StarCoder14/Auto_DRIVING/다음_할일.md

# 인수인계 / 다음 할 일 (2026-10-27 기준)

하드웨어는 다 움직인다. 지금은 **오렌지파이에서 리모컨으로 거리를 정해 자율주행을 시작**하는 단계다.
자세한 기록은 `실물_올리기.md` 6-7 절.

## 지금 상태

| 항목 | 상태 |
|---|---|
| 앞 거리 센서(샤프 A0), 센서 서보(D9), 자이로, 부저(D13) | 확인됨 |
| 조향 서보 D10 | 확인됨 (D8 에 꽂혀 있던 선을 D10 으로 옮김) |
| DC 모터 2개, L9110S D4~D7 | 펌웨어 고친 뒤 명령 없을 때 멈춤 확인 |
| 오렌지파이 ↔ 나노 USB 직결 | 확인됨. 50 Hz 상태 줄, 감시 정지 동작 |
| 리모컨 펌웨어 (거리 입력 + ▶\|\| 출발) | 컴파일·업로드 성공. 켜면 `사람조종`(대기) 확인 |
| 리모컨 ▶\|\| 로 실제 출발, 도착 | **아직 확인 안 함** |
| 전원만 켜면 자동 대기 (`scripts/start_car.sh` + crontab) | **안내만 함. 등록 확인 안 함** |
| 바닥에서 실제 자율주행 | **아직** |

## 어떻게 동작하나

- 아두이노: 센서 훑기, 모터·조향 출력, 감시 정지, **리모컨 읽기**. 켜면 멈춘 상태.
- 오렌지파이 `run_robot.py`: 지도, 하이브리드 A\*, 추종. 리모컨이 '멈춤' 이면 `사람조종` 으로 기다린다.
- 리모컨: 숫자(cm) → ▶\|\| 를 누르면 아두이노가 `G,<cm>` 를 보내고, 파이가 그 순간 차가 보는 방향으로 목적지를 잡아 출발.
  달리는 중 아무 버튼 = 정지. 다시 ▶\|\| = 이어 감. EQ = 숫자 지우기.
- `run_robot.py` 가 안 떠 있으면 리모컨을 눌러도 삑 소리만 나고 안 움직인다. 자동으로 띄우려면 `scripts/start_car.sh`.

## 보드 작업 방법 (노트북 없이)

- 보드 코드: `~/Auto_DRIVING` (github.com 에서 clone 한 뒤 `rccar/link.py`, `rccar/robot.py` 를 손으로 고침 = 이 레포와 같은 내용)
- 아두이노 스케치: `~/rccar_arduino/rccar_arduino.ino` (= 이 레포 `firmware/rccar_arduino/rccar_arduino.ino` 와 같은 동작)
- **`~/Auto_DRIVING` 를 지우거나 다시 clone 하지 말 것.** 이 레포가 올라가기 전에는 손으로 고친 게 날아간다.
- 포트: `ls /dev/ttyUSB*` 로 확인 (0, 1 이 바뀜)
- 컴파일은 `--clean` 필수 (보드 시계가 틀어짐), 업로드는 리셋 버튼 손으로. 명령은 `실물_올리기.md` 6-7.
- 편집기는 `nano` (Ctrl+W 찾기, Ctrl+_ 줄 번호로 가기, Ctrl+O 저장, Ctrl+X 나가기)

## 바로 다음

1. **리모컨 출발 시험** (모터 빼고도 됨): `run_robot.py` 실행 → `1 0 0` → ▶\|\| → 화면 위치가 1.0 까지 늘고 `결과: 도착`
2. 센서 서보와 DC 모터 다시 꽂기. **센서 서보가 빠져 있으면 지도가 엉뚱하게 찍힌다.**
3. 바퀴 띄우고 ▶\|\| → 두 바퀴가 같은 방향으로 도는지. 한쪽이 거꾸로면 그 모터 선 두 가닥을 바꿈
4. 바닥에서 첫 주행: 장애물 없이 100 cm. 출발 전 2 초 가만히 (자이로 영점)
5. `scripts/start_car.sh` 를 `~/start_car.sh` 로 두고 crontab 등록, 재부팅해서 전원만으로 대기되는지 확인

## 알려진 문제와 주의

- **0.33 m/s 아래 명령은 모터가 꺼진다** (`MOTOR_MIN_PWM = 60`). 계획기가 감속하면 서 버릴 수 있다. 안 가면 `--max-speed` 를 올리거나 이 값을 실측으로 낮춘다.
- **도착 판정 반경 0.45 m, 계획기 설정이 큰 차(48 cm) 기준.** 30 cm 보다 짧은 거리는 바로 도착할 수 있다. 차 크기에 맞게 줄이는 작업이 남았다 (step 0.40→~0.15, goal_tol 0.45→~0.15, grid_res). 리모컨 거리 보정(`robot.py` 의 `+ self.C.goal_tol`)도 같이 볼 것.
- **엔코더가 없어** 거리는 명령 속도 × 시간으로 짐작한다. 3 m 달리기로 명령 대비 실제 속도를 재서 보정할 것.
- 펌웨어 후진은 D4, D7 이 PWM 핀이 아니라 제대로 안 된다. 뒤 센서가 없어 후진을 꺼 둬서 지금은 상관없다.
- 리모컨은 수신기를 향해 눌러야 한다. 비상 정지는 **모터 배터리 스위치**가 제일 확실하다.
- 오렌지파이 전원은 아직 콘센트. 5V 3A 이상 USB-C 보조배터리가 있어야 선 없이 달린다.

## 측정 남은 것 (`rccar/car_specs.py`)

윤거, **최소 회전 지름 좌/우** (가장 중요), 조향 서보 중앙값, 앞 센서 위치·높이, 시험 공간, 기둥 지름·높이.
안 잰 값은 기본값(최대 조향 32도 등)으로 채워 달린다.

## 그 뒤

- 시뮬레이터·계획기 설정을 22 cm 차에 맞게 축소 (계획 먼저 보여주고 진행)
- 계획서 수정안(센서 샤프·보드·방법), 보고서 서론/배경. 보고서 마감 약 11/8
