StarCoder14/Auto_DRIVING/실물_올리기.md

# 실물에 올리기

시뮬레이터에서 검증한 알고리즘을 오렌지파이와 아두이노로 옮기는 방법이다.
부품이 오기 전에 만들어 둔 것과, 부품이 온 뒤에 할 일을 나눠 적었다.

작성: 2026-09-16

---

## 1. 무엇이 어디서 도는가

| 담당 | 파일 | 하는 일 |
|---|---|---|
| 오렌지파이 | `run_robot.py`, `rccar/robot.py` | 지도 만들기, 하이브리드 A\*, 경로 추종, 예측 정지 |
| 아두이노 | `firmware/rccar_arduino/rccar_arduino.ino` | ToF 2개와 자이로 읽기, 센서 서보 훑기, 조향과 모터 출력, 감시 정지 |
| 둘 사이 | `rccar/link.py` | 글자로 주고받는 통신 규약 |
| 부품 없이 시험 | `rccar/fake_arduino.py` | 아두이노인 척하는 가짜 장치 |

알고리즘 자체는 시뮬레이터와 같은 코드를 쓴다 (`rccar/hybrid.py`).
바뀌는 것은 센서 값을 어디서 받고 명령을 어디로 보내느냐뿐이다.

## 2. 통신 규약

한 줄짜리 글자로 주고받는다. 시리얼 모니터로 눈으로 볼 수 있어야 고치기 쉽다.

```
아두이노 -> 파이   S,<ms>,<자이로>,<센서각>,<앞거리>,<뒷거리>,<실제명령>,<플래그>*<검사값>
파이 -> 아두이노   C,<속도mm/s>,<조향0.1도>*<검사값>
```

- 검사값은 앞 글자들을 XOR 한 16 진수 두 자리다. 선이 흔들려 깨진 줄은 버린다.
- 아두이노는 50 Hz 로 상태를 보낸다.
- **명령이 0.3 초 안 오면 아두이노가 스스로 차를 세운다.** 파이가 죽어도 차는 선다.
- 자세한 항목 설명은 `rccar/link.py` 머리말에 있다.

## 3. 부품 없이 지금 할 수 있는 것

```bash
python -m tests.test_robot                 # 통신과 주행 시험 7개 (몇 초)
python run_robot.py --fake --seed 2005     # 가짜 아두이노로 전체 주행
```

가짜 아두이노는 서보가 멈춘 뒤 재는 것, 자이로 편향과 잡음, 통신 지연 0.02 초,
감시 정지까지 흉내 낸다. 그래서 통신 형식과 주행 논리는 부품 없이 검증된다.

흉내 내지 못하는 것은 실물에서 처음 만난다. 서보의 기계적 흔들림, 변속기의 후진 지연,
바퀴 미끄러짐, 센서가 유리나 검은 면을 놓치는 것이다.

## 4. 배선

핀 번호는 `.ino` 파일 위쪽 상수에서 바꾼다. **2026-10-26 기준 실제 배선** (처음 계획에서 많이 바뀌었다):

| 부품 | 아두이노 핀 |
|---|---|
| 자이로 MPU6050 (I2C) | SDA A4, SCL A5 |
| 앞 거리 센서 샤프 GP2Y0A21 (아날로그) | A0 |
| 센서 서보 (앞 센서 좌우로 훑기) | D9 |
| 조향 서보 | D10 |
| DC 모터 드라이버 L9110S, 모터 2개 | B-1A D4, B-1B D5, A-1A D6, A-1B D7 |
| 적외선 리모컨 수신기 OUT | D2 |
| 능동 부저 | D13 (나노 L LED 와 같은 핀) |

- 뒤 센서는 없다. ToF 는 쓰지 않는다 (샤프로 바꿈).
- 드라이버 VCC 는 모터 배터리, **GND 는 나노와 공통**.
- 나노는 오렌지파이 USB 에 바로 꽂는다 (CP2102 어댑터 안 씀). 보드에서 `/dev/ttyUSB0` 또는 `ttyUSB1` 로 보이고, 다시 꽂으면 번호가 바뀐다.

## 5. 부품이 온 뒤 순서

한 번에 다 붙이지 않는다. 각 단계의 통과 기준을 만족한 뒤 다음으로 간다.

| 단계 | 할 일 | 통과 기준 |
|---|---|---|
| 1 | 오렌지파이에 운영체제, 파이썬, numpy 설치 | `python -m tests.test_hybrid` 통과 |
| 2 | 보드 속도 측정 | `python run_robot.py --fake` 가 실시간으로 돌아감 |
| 3 | 아두이노에 펌웨어 넣고 시리얼 모니터로 확인 | `S,...` 줄이 50 Hz 로 올라옴 |
| 4 | 바퀴를 띄우고 조향과 모터 확인 | `C,...` 를 보내면 움직이고, 끊으면 0.3 초 안에 멈춤 |
| 5 | 조향 보정 | 핸들 끝까지 꺾고 원을 그려 지름을 잼. `STEER_GAIN` 조정 |
| 6 | 속도 보정 | 3 m 를 달린 시간을 재서 명령 대비 실제 속도 비율 확인 |
| 7 | 센서 확인 | 손으로 밀며 파이 화면에 지도가 쌓이는지 봄 |
| 8 | 낮은 속도로 자율주행 | `--max-speed 0.4` 로 시작 |

### 단계 4 에서 쓰는 명령

시리얼 모니터에서 직접 쳐 볼 수 있다. 줄바꿈을 보내야 한다.

```
C,300,0*<검사값>      앞으로 0.3 m/s
C,0,150*<검사값>      제자리에서 조향만 15 도
C,0,0*<검사값>        정지
```

검사값은 파이썬으로 뽑는다.

```bash
python -c "from rccar.link import encode_cmd; import math; print(encode_cmd(0.3, 0).decode())"
```

## 6. 실물에서 처음 만날 문제

| 문제 | 왜 생기나 | 대응 |
|---|---|---|
| 지도가 밀린다 | 엔코더가 없어 '명령 속도 x 시간' 으로 거리를 짐작한다. 15 초 직진에 1 m 가까이 틀릴 수 있다 | 짧은 주행으로 시험한다. 심하면 엔코더를 단다 |
| 방향이 돈다 | 자이로 편향. 가만히 있어도 각도가 흘러간다 | 켤 때 2 초간 차를 가만히 두고 편향을 잰다 (펌웨어가 한다) |
| 장애물이 엉뚱한 곳에 찍힌다 | 센서 서보가 늦게 따라가는데 그 각도로 기록한다 | 방향마다 90 ms 기다렸다 잰다 (`SWEEP_SETTLE_MS`). 아래 표 참조 |
| 후진이 안 된다 | RC 변속기는 브레이크를 거쳐야 후진하는 제품이 많다 | 변속기를 확인하고, 필요하면 펌웨어에 브레이크 절차를 넣는다 |
| 차가 너무 빠르다 | RC카는 시뮬레이터보다 훨씬 빠르다 | 펌웨어 `MAX_SPEED_MMS` 와 `--max-speed` 로 두 겹 제한 |
| 계획이 늦다 | 보드가 PC 보다 느리다 | 단계 2 에서 미리 잰다. 느리면 지도 범위를 줄인다 |

### 센서 서보 지연 실험 (무작위 지도 20개, 가짜 아두이노)

| 설정 | 도착 | 기둥에 닿음 | 가장 작은 차체 여유 | 잴 때 각도 오차 |
|---|---|---|---|---|
| 지연 없음 (이상) | 20/20 | 0 | 0.117 m | 0도 |
| 대기 45 ms | 20/20 | 0 | 0.068 m | 6.7도 |
| **대기 90 ms (채택)** | 20/20 | 0 | 0.109 m | 1.2도 |
| 느린 서보 150도/초, 대기 45 ms | 10/20 | **11** | **-0.262 m** | 34.4도 |

- 서보는 **0.1 초/60 도 이하**로 고를 것. 느리면 차가 기둥에 박는다.
- 대기를 90 ms 로 늘리면 덜 재는 대신 각도가 정확해진다. 주행 시간은 0.4 초 늘었다.
- 더 좋은 해법은 각도를 읽을 수 있는 서보를 써서 실제 각도를 보고하는 것이다. 부품값이 오른다.

## 진행 기록

### 2026-09-16 단계 1, 2 통과

**보드**: 오렌지파이 5, 메모리 16 GB, 우분투 20.04.6, 파이썬 3.8.10, 커널 6.1.99

**접속 방법** (키보드 없이 노트북에서)
- 보드 랜선을 교실 천장 무선 공유기의 빈 LAN 포트에 꽂았다. 노트북과 같은 학교망(172.16.x.x)이 된다.
- 바닥 랜 포트는 다른 망(192.168.0.x)이라 노트북에서 보이지 않았다.
- 노트북에 SSH 열쇠를 등록했다. 이제 `ssh orangepi@172.16.1.2` 로 비밀번호 없이 들어간다.
- **보드 주소는 바뀔 수 있다.** 안 들어가지면 보드 화면에서 마우스로 네트워크 아이콘을 눌러 주소를 다시 확인한다.

**설치** (관리자 비밀번호 없이)

```bash
cd /tmp && curl -sSL -o get-pip.py https://bootstrap.pypa.io/pip/3.8/get-pip.py
python3 get-pip.py --user
python3 -m pip install --user numpy pyserial      # numpy 1.24.4, pyserial 3.5
```

- 사용자 `orangepi` 는 이미 `dialout` 그룹이라 아두이노 포트 권한 설정이 필요 없다.
- 코드는 보드의 `~/rccar` 에 있다.

**단계 1**: `tests.test_hybrid` 9개, `tests.test_robot` 7개 전부 통과

**단계 2**: 가짜 아두이노로 무작위 지도 5개를 달리며 주기마다 계산 시간을 쟀다.

| 항목 | 예산 | 노트북 | 오렌지파이 5 |
|---|---|---|---|
| 계획 한 번 평균 | 100 ms | 9.3 ms | 16.0 ms |
| 계획 한 번 최악 | 100 ms | 51.4 ms | 68.1 ms |
| 추종 한 번 평균 | 20 ms | 0.2 ms | 0.4 ms |
| 예산 초과 | | 0% | 0% |

측정 뒤 칩 온도 56 도. 방열판 없이 짧게 돌린 결과라 오래 달리면 다시 잴 것.

**발견한 문제**: 5 판 중 무작위 지도 2016 번에서 60 초 동안 제자리에 멈췄다.
예측 정지 2,903 번, 계획 585 번. 기둥에 붙은 차를 계획기는 빼내려 하고 예측 정지는
그 움직임을 막는 것을 끝없이 반복했다. 박지는 않으므로 안전 문제는 아니다.
노트북에서도 똑같이 실패하므로 보드 속도와는 무관하다.

### 2026-09-16 이어서 할 일 (여기서 멈춤)

**와이파이 모듈이 인식되지 않는다.**
커널 기록에 `rk-pcie fe190000.pcie: PCIe Link Fail`, `failed to initialize host` 가 찍힌다.
보드에 모듈 펌웨어(`/lib/firmware/ap6275p`)는 있으므로 소프트웨어가 아니라 접촉 문제로 본다.
모듈 고정 핀이 풀려 비스듬히 떠 있었다. 평평하게 눌러 고정한 뒤 다시 확인해야 한다.

- 확인 명령 (노트북에서): `ssh orangepi@<보드주소> "nmcli dev status"` 에 `wlan0` 이 보이면 성공
- 성공하면 학교 와이파이 `G096_IoT_2.4G` 비밀번호를 받아 `nmcli` 로 연결한다
- 계속 안 되면: 리눅스 기본 드라이버가 있는 USB 와이파이 동글, 또는 랜선을 뽑은 뒤 달리는 방식

**실물 주행 프로그램에서 고친 것 (`rccar/robot.py`)**

가짜 아두이노로 조정용 지도 40 개를 돌려 갇힘 1 판(17 번)과 기둥 접촉 1 판(35 번, 9 mm)을 찾았다.
둘 다 출발 1 초 만에 기둥에 붙은 것이었다.

| 원인 | 고친 것 |
|---|---|
| 서보가 좌우를 다 훑기 전에 출발해서 못 본 기둥 쪽으로 감 | 앞 센서가 좌우 70 도까지 한 번씩 본 뒤 출발 |
| 예측 정지 기준이 격자 오차(반 칸 대각선 8.5 cm)를 빼먹음 | 기준에 더함 |
| 한번 붙으면 모든 움직임이 막혀 멈춤과 재계획을 무한 반복 | 1 초 가까이 계속 멈추면, 뒤 ToF 가 방금 45 cm 이상 비었다고 잰 경우에만 25 cm 곧게 후진 |

17 번, 35 번, 2016 번 모두 도착했다 (예측 정지 0 번). 시험 7 개 통과.

처음 보는 지도 4000~4039 번 채점 (가짜 아두이노, 서보 지연 포함):

| 항목 | 결과 |
|---|---|
| 도착 | 40/40 |
| 기둥에 닿음 | 0 |
| 가장 작은 차체 여유 | 0.114 m |
| 후진 탈출을 쓴 판 | 1 (4018 번, 2 번 탈출한 뒤 도착) |

**아직 할 일**: 고친 코드를 보드로 보내기.

### 2026-09-21 보드 준비 마무리

**와이파이는 포기한다.** 모듈을 다시 꽂고 전원을 여러 번 껐다 켠 뒤에도 `nmcli dev status` 에
`eth0` 만 보인다. 커널은 계속 `PCIe Link Fail` 을 낸다. 다음 중 하나로 간다.

- USB 와이파이 동글 (리눅스 기본 드라이버가 있는 모델). 사기 전에 모델명 확인
- 커널 5.10 판 이미지로 시험 (예비 SD 카드 있음)
- **와이파이 없이 시연.** 주행에는 지장이 없다. 아래 흐름 참조

**와이파이 없이 시연하는 흐름**

1. 차에 키보드와 모니터를 꽂고 출발선에 놓는다. 전원을 넣고 2 초간 가만히 둔다 (자이로 편향 측정).
2. `python3 run_robot.py --port /dev/ttyUSB0 --goal 3 0 --max-speed 0.4` 를 치고 엔터.
3. **부저가 10 초 카운트다운을 울린다** (마지막 3 초는 빠르게). 그 사이 키보드와 모니터 선을 뽑는다.
4. 카운트다운이 끝나면 출발한다. 전원만 켠다고 달리지는 않는다 — 이 명령을 쳐야 움직인다.
5. 멈출 때는 RC 조종기 스위치 또는 모터 전원 스위치.

카운트다운 시간은 `--countdown 15` 처럼 바꾸고, `--countdown 0` 으로 끈다 (시험할 때).
부저는 D13 에 달려 있다. 능동형이라고 보고 핀만 켜고 끈다. 실제로 소리가 안 나면 수동형이므로
펌웨어의 `beepSet()` 한 곳을 `tone(PIN_BUZZER, 2000)` / `noTone(PIN_BUZZER)` 로 바꾼다.
나중에 키보드 없이 **조종기 스위치로 시작**하게 만들 예정 (조종기 채널 배선 확정 후).

**보드에 설치한 것**: matplotlib (pip --user), tmux (apt), `~/demo.sh` (시뮬레이션 한 줄 실행)

**보드에서 확인한 것**: `tests.test_hybrid`, `tests.test_sensors`, `tests.test_robot` 전부 통과.
창을 띄운 시뮬레이션과 가짜 아두이노 주행 모두 정상.

**노트북에서 보드로 접속할 때 주의**: 학교망이 날마다 다른 대역을 준다.
2026-09-16 에는 노트북 172.16.24.152 / 보드 172.16.1.2 로 같은 대역이라 접속됐지만,
2026-09-21 에는 노트북 11.214.120.116 / 보드 192.168.1.217 로 갈라져 접속할 수 없었다.
보드 화면에서 주소를 확인하고, 대역이 다르면 원격 접속을 포기하고 보드 키보드로 작업한다.

## 6-3. 2026-09-22 아두이노 첫 연결과 무선 접속

**아두이노 실물에서 통신을 검증했다.** 부품(센서·서보)은 아직 없지만, 통신 계층은 끝났다.

쓴 부품은 친구에게 받은 **아두이노 나노**(미니 USB, 옛 부트로더)와 **CP2102 USB-TTL 어댑터**다.
나노의 USB 케이블이 없어 어댑터로 업로드했다. DTR 이 나노 핀으로 빠져 있지 않으므로
업로드 버튼을 누른 뒤 손으로 리셋을 눌렀다 떼는 방식(방법 A)을 썼다.

| 항목 | 결과 |
|---|---|
| 상태 문장 수신 | 153 줄, 체크섬 실패 0 |
| 주기 | 최소 20 ms / 최대 20 ms — 정확히 50.0 Hz |
| 명령 안 보낼 때 | watchdog 100 % (스스로 정지) |
| 명령 보낼 때 | watchdog 0 % |

마지막 두 줄이 핵심이다. **감시 정지가 실물에서 작동한다.** 시뮬레이터에서만 보던 것을 확인했다.
센서가 없으므로 front/rear 는 `inf` 로 나온다. 정상이다.

**펌웨어 버그 하나를 고쳤다.** `for (VL53L1X* s : {&tofFront, &tofRear})` 는 AVR 컴파일러가
받지 못한다 (`deducing from brace-enclosed initializer list requires #include <initializer_list>`).
배열을 만들어 도는 방식으로 바꿨다. 크기는 15388 바이트(50 %), 전역 655 바이트(31 %).

**배선** (차 배터리 스위치는 끈 채로, 나노는 어댑터 5 V 로 켠다)

| USB-TTL | 나노 |
|---|---|
| GND | GND |
| TX | RX0 |
| RX | TX1 |
| 5V | 5V |

**아두이노 IDE 설정**: 보드 Arduino Nano / 프로세서 ATmega328P (Old Bootloader) / 포트 COM9.
CP2102 는 자기를 아두이노라고 말하지 않으므로 보드와 포트를 손으로 지정해야 한다.
드라이버는 실리콘랩스 CP210x Universal Windows Driver 를 `pnputil` 로 설치했다.

**이 차의 부저는 D13 에 달려 있다.** 나노의 `L` LED 와 같은 핀이다. 실드에 가려 LED 가
안 보이므로, 업로드 성공 여부는 소리로 알 수 있다. 우리 펌웨어는 D13 을 쓰지 않는다.

**무선 접속이 됐다.** 그동안 안 되던 와이파이가 이 날 연결됐다.
노트북 172.16.15.185 / 보드 172.16.1.2 로 같은 대역이었고, 예전 SSH 키가 그대로 통했다.
파일은 `scp` 로 보낸다. USB 메모리로 옮기려던 시도는 `mount` 에서 막혀 접었다.

```
scp run_forever.py loop.py orangepi@172.16.1.2:~/rccar/
scp rccar/viz.py orangepi@172.16.1.2:~/rccar/rccar/
```

**무작위 지도를 끝없이 보여주는 것을 만들었다.** `run_forever.py` 다.
창 하나를 계속 다시 쓰고, 한 판이 끝나면 결과를 잠깐 보여준 뒤 다음 시드로 넘어간다.
이를 위해 `viz.Viewer` 에 `fig` 인자를 더했다 (주면 그 창을 비우고 재사용한다).
끝내는 법은 Ctrl+C 또는 창 닫기. 터미널에 누적 도착률이 쌓이므로 오래 틀어두면 그대로 측정이 된다.

```
cd ~/rccar && python3 run_forever.py
```

`loop.py` 는 같은 일을 하는 24 줄짜리 축약판이다. 파일을 옮길 방법이 없어 손으로 칠 때를 위해 남겨 둔다.

## 6-4. 2026-10-19 센서 하나로 바꿈, 주행 기록

**센서는 앞 ToF 하나뿐이다.** 서보에 올려 좌우로 훑고, 뒤 센서는 달지 않는다.

| 바뀐 곳 | 내용 |
|---|---|
| 펌웨어 `USE_REAR_TOF = 0` | 없는 뒤 센서를 켜거나 읽지 않음. 후진 명령은 받아도 0 으로 자름 (`MAX_REV_MMS`). 컴파일 확인: 저장 공간 50%, 메모리 31% |
| `rccar/car_specs.py` `has_rear_tof: False` | 이 값을 보고 오렌지파이 쪽도 후진 경로를 안 만듦 |
| `robot.py` 갇힘 처리 | 뒤를 못 보니 후진 탈출을 안 함. 출발 준비 뒤 5 초 동안 계속 서 있으면 '갇힘' 으로 끝내고 섬. 사람이 조종기로 꺼냄 |

가짜 아두이노로 처음 보는 지도 4000~4039 번: **38/40 도착, 2 개 갇힘(4023, 4029)으로 안전하게 멈춤, 후진 명령 0 번.**
하드웨어_준비.md 의 '서보 ToF만: 38/40' 과 같다.

처음엔 '1 초에 25 번 멈춤' 을 갇힘으로 봤는데, 출발 직후 첫 경로를 찾느라 잠깐 서는 것까지 걸려서
지도 17 번이 2.4 초 만에 끝났다. 뒤 센서가 있으면 후진 없이 도착하는 지도였다. 그래서 '5 초 동안 계속 섬' 으로 바꿨다.

**주행 기록.** `run_robot.py` 가 매번 `logs/run_날짜_시각.csv` 를 남긴다 (`--no-log` 로 끔).
50 Hz 로 시간, 차가 믿은 위치와 방향, 속도, 보낸 명령, 센서 각도와 거리, 상태를 적는다.
실차 실험 뒤 `run_error_split.py --robot-log` 로 주면 바닥 궤적과 비교해 실차의 위치 추정 오차를 낸다.

**보드로 보낼 파일** (실차 주행 전에 한 번)

```
scp rccar/robot.py rccar/car_specs.py rccar/vehicle.py rccar/sensors.py rccar/hybrid.py rccar/fake_arduino.py orangepi@<보드주소>:~/rccar/rccar/
scp run_robot.py orangepi@<보드주소>:~/rccar/
```

펌웨어도 다시 올려야 한다 (`USE_REAR_TOF`, 그리고 car_specs 가 알려주는 `MAX_STEER_DEG`, `STEER_CENTER_DEG`).

**시험 공간 크기.** 시뮬레이터 기본 차(길이 48 cm, 최소 회전 반경 53 cm)로 공간 크기별 도착을 쟀다 (배치 6 개).
1.5 m 는 다 아는 차도 2/6, 2 m 는 4/6, 3 m 는 5/6. 계획서의 1.5 m 는 이 크기 차에는 좁다.
**차 길이의 6 배 정도**를 잡을 것. 우리 차를 재면 `python run_error_split.py --map arena` 로 다시 볼 것.

## 6-5. 2026-10-19 보드로 보내는 명령 하나로 묶음 (deploy.py)

파일마다 scp 를 치던 것을 `deploy.py` 하나로 묶었다. 핀 번호는 아두이노 펌웨어에만 필요하므로,
차체가 확정되기 전에도 오렌지파이 파이썬 코드는 올려서 보드 속도를 미리 잴 수 있다.

```
python deploy.py <보드주소>             # rccar, tests, run*.py, layouts 를 보내고 시험까지 돌림
python deploy.py <보드주소> --check     # 접속만 확인
python deploy.py <보드주소> --time      # 가짜 아두이노로 계획 주기 시간을 잼
python deploy.py <보드주소> --pull-logs # 보드의 주행 기록(logs/)을 노트북으로 가져옴
```

recordings, logs, 버릴것, __pycache__ 는 빼고 보낸다 (48 개 파일, 약 160 KB).

**네트워크 주의 (여러 번 막힌 곳).** 노트북과 보드가 같은 대역이어야 접속된다.

| 날짜 | 노트북 | 보드 | 됐나 |
|---|---|---|---|
| 2026-09-16 | Wi-Fi 172.16.x | 천장 공유기 LAN 포트 → 172.16.x | O |
| 2026-09-21 | Wi-Fi 11.x | 192.168.1.x | X (다른 대역) |
| 2026-10-19 | Wi-Fi 192.168.100.x | 192.168.1.x | X (다른 대역) |

2026-10-19 에는 공유기에 직접 랜을 꽂았는데도 보드가 192.168.1.x 를 받아 노트북(192.168.100.x)과 갈렸고,
선생님 노트북에서도 접속되지 않았다. 보드가 그 공유기에서 주소를 제대로 못 받는 것으로 보인다.
확인할 것: 보드 화면에서 `hostname -I`. 노트북과 앞 세 자리가 같은 주소가 없으면 접속 불가.
- 랜선을 노트북 Wi-Fi 와 같은 공유기의 LAN 포트로 옮긴다.
- 그래도 안 되면 노트북과 보드를 랜선으로 직접 잇는다 (둘 다 169.254.x 를 받음).
- 다 안 되면 보드에 키보드·모니터를 꽂아 직접 작업한다. 무선/원격 없이도 주행은 된다.

## 6-6. 2026-10-21 새 코드 보드에 올리고 확인

172.16 망에서 접속됨 (노트북 172.16.60.228, 보드 172.16.1.3, Wi-Fi G096_IoT_2.4G).
**학교가 네트워크를 바꾼 게 아니라, 그날 노트북이 어느 Wi-Fi/망에 붙느냐의 차이였다.**
접속 안 될 때는 노트북이 G096_IoT_2.4G(172.16.x)에 붙어 있는지부터 볼 것.

| 확인 | 결과 |
|---|---|
| 새 코드 48개 파일 전송 | 성공 (car_specs, error_split, 주행 기록, 삑삑 카운트다운, 뒤 센서 없이 달리기) |
| 보드에서 시험 (차 사양, 실물 준비) | 전부 통과 (파이썬 3.8.10) |
| 가짜 아두이노 주행 + 주행 기록 CSV | 도착, 기록 정상 |
| 계획 주기 시간 | 평균 8.3 ms, p95 32.4 ms (예산 100 ms). 주행 기록 추가해도 안 느려짐 |
| 칩 온도 | 48도 (9월 56도보다 시원, 여유 있음) |

**Windows scp 주의.** `deploy.py` 가 tar 를 바로 스트리밍하면 중간에 멈추는 일이 있었다.
tar 를 로컬 파일로 만든 뒤 scp 로 보내고 보드에서 풀면 안정적이다.
SSH 접속 때 뜨는 post-quantum 경고는 보안 안내일 뿐 전송에는 문제없다.

## 6-7. 2026-10-26~27 오렌지파이 직결, 모터 2개, 리모컨

노트북 없이 **오렌지파이에 모니터·키보드를 꽂고** 전부 작업했다. 이 날 한 것과 겪은 문제.

**오렌지파이 ↔ 나노 USB 직결 확인.** `stty -F /dev/ttyUSB0 115200 raw; cat /dev/ttyUSB0` 로 `S,...` 줄이 들어오고,
파이썬 `SerialLink` 로 조향 좌우, 부저, 감시 정지(명령 끊으면 핸들이 저절로 가운데)를 확인했다.

**바퀴가 꺼져도 켜져도 계속 돌았다.** 모터가 2 개라 드라이버 A, B 채널을 D4~D7 에 꽂았는데,
펌웨어는 모터 1 개용(D5, D6)이라 D4, D7 이 떠 있었다. L9110S 는 뜬 입력을 HIGH 로 읽어 모터를 돌린다.
펌웨어에서 A 채널을 D6/D7 로 바꾸고 B 채널(D5/D4)에 같은 값을 쓰게 고쳐 해결.

**조향 서보가 D8 에 꽂혀 있었다.** 선을 D10 으로 옮겼다.

**오렌지파이에서 아두이노 업로드 (arduino-cli).** 노트북이 없어 보드에서 컴파일과 업로드를 한다.

```
# 처음 한 번 (인터넷 필요)
curl -fL -o ~/cli.tgz https://downloads.arduino.cc/arduino-cli/arduino-cli_latest_Linux_ARM64.tar.gz
mkdir -p ~/bin && tar xzf ~/cli.tgz -C ~/bin
~/bin/arduino-cli core update-index && ~/bin/arduino-cli core install arduino:avr
~/bin/arduino-cli lib install Servo IRremote

# 스케치는 ~/rccar_arduino/rccar_arduino.ino (폴더와 파일 이름이 같아야 함)
cd ~/rccar_arduino
~/bin/arduino-cli compile --clean -b arduino:avr:nano:cpu=atmega328old
~/bin/arduino-cli upload -p /dev/ttyUSB0 -b arduino:avr:nano:cpu=atmega328old   # 리셋 누른 채 엔터, 0.5 초 뒤 뗌
```

- `raw.githubusercontent.com` 은 학교망에서 막혔다. 레포는 `git clone https://github.com/StarCoder14/Auto_DRIVING` (github.com) 으로 받는다.
- **자동 리셋이 안 된다.** `not in sync: resp=0x2c` 처럼 `,` `S` 같은 글자가 오면 펌웨어가 그대로 돌고 있는 것. 리셋을 손으로 누른다.
- **`--clean` 을 꼭 붙인다.** 보드 시계가 인터넷 없으면 틀어져서(화요일인데 월요일 17시) 고친 파일이 옛 빌드보다 오래된 것으로 보여, 컴파일러가 옛 결과를 재사용했다. 고친 오타가 계속 오류로 나왔던 원인.
- 업로드 전에 `cat`, `python3`, `run_robot.py` 를 끈다. 포트를 쓰고 있으면 실패한다.

**리모컨으로 거리 정해 출발.** 수신기 D2, Car mp3 21 키 리모컨 (NEC).

| 버튼 | 하는 일 |
|---|---|
| 숫자 | 갈 거리(cm). 누를 때마다 짧게 삑 |
| ▶\|\| | 출발. 숫자가 없으면 멈춘 데서 이어 감 |
| EQ | 숫자 지우기 |
| 달리는 중 아무 버튼 | 즉시 정지 (아두이노가 직접 멈춤) |

- 켜면 멈춘 상태. 멈춘 동안은 '사람 조종' 플래그(4)를 올려 `robot.py` 가 계획을 쉬며 기다린다. 화면에 `사람조종`.
- 출발할 때 아두이노가 `G,<cm>*<검사값>` 을 보내고, `link.py` 가 받아 `robot.py` 가 **그 순간 차가 보는 방향으로** 목적지를 잡는다.
  도착 판정 반경(0.45 m)만큼 목적지를 더 멀리 놓아, 곧게 가면 입력한 거리 근처에서 선다. 차 크기에 맞게 반경을 줄이면 이 보정도 같이 볼 것.
- 가짜 아두이노로 100 cm 를 넣어 지도 2 개에서 1.00 m 가서 도착함을 확인. 실차는 엔코더가 없어 명령 속도로 거리를 짐작하므로 실제 거리는 다를 수 있다.
- 실행: `python3 run_robot.py --port /dev/ttyUSB0 --goal 99 0 --max-speed 0.5 --countdown 0 --max-time 600` (`--goal` 은 자리만 채우는 값)

**전원만 켜고 리모컨으로 출발하게 하기.** `scripts/start_car.sh` 를 보드 `~/start_car.sh` 로 두고 `crontab -e` 에
`@reboot /home/orangepi/start_car.sh >> /home/orangepi/car.log 2>&1`. 켜지면 주행 프로그램이 떠서 리모컨을 기다리고,
도착하면 다시 기다린다. (2026-10-27 안내함. 실제 등록과 재부팅 확인은 아직.)

## 7. 안전

- **아두이노의 감시 정지가 1차 방어선이다.** 파이가 멈추든, 선이 빠지든, 프로그램을 Ctrl+C 로 끊든 차는 선다.
- **RC 조종기를 무선 비상 정지로 쓴다.** 펌웨어에서 `USE_RC` 를 1 로 두고 채널을 연결하면, 사람이 스위치를 올렸을 때 자율주행 명령이 무시된다.
- **모터 전원을 끊는 물리 스위치를 둔다.** 소프트웨어가 무엇을 하든 사람이 끊을 수 있어야 한다.
- 시험할 때는 바퀴를 띄우고 시작한다. 바닥에 내리는 것은 단계 8 부터다.
