StarCoder14/Auto_DRIVING/하드웨어_준비.md

# 하드웨어 준비 계획

시뮬레이터의 하이브리드 A\* 알고리즘을 실제 RC카에 올리기 위한 준비 계획이다.
친구가 가진 부품의 정확한 사양을 받는 대로 고친다.

작성: 2026-09-14, 수정: 2026-09-15 (두뇌 보드를 오렌지파이 5로, 센서를 ToF 2개와 서보 1개로 확정)

---

## 1. 결정한 것

| 항목 | 결정 |
|---|---|
| 차 종류 | 서보로 앞바퀴를 꺾는 RC카형 |
| 알고리즘 | 하이브리드 A\*. 아래 두 계획 모두 같은 코드를 쓴다 |
| 두뇌 보드 | 오렌지파이 5, 메모리 16 GB (뒷면 스티커 OPi5 16G). M.2 슬롯에 와이파이·블루투스 모듈 AP6275P 장착 |
| 거리 센서 | 레이저 ToF 2개. 앞 1개는 서보에 올려 좌우로 훑고, 뒤 1개는 고정 |
| 지도 기록 | 원뿔 끝 호 전체에 기록 (가는 기둥을 멀리서부터 피한다) |
| 후진 | 평소에는 전진만 계획하고, 막혔을 때만 0.25 m/s 로 느리게 후진 |
| 방향 센서 | 자이로 MPU6050 |
| 비상 정지 | 명령이 끊기면 마이크로컨트롤러가 스스로 정지한다. 물리 스위치와 RC 조종기도 둔다 |

### 왜 일반 아두이노 하나로는 안 되나

알고리즘이 파이썬과 numpy로 돌아가고, 점유 격자와 거리장만 각각 약 285 KB가 필요하다.
아두이노 우노의 작업용 메모리는 2 KB, 메가는 8 KB다. 그래서 무거운 계산은 보드 컴퓨터가 하고,
아두이노는 모터와 센서만 맡는다.

### 센서를 이렇게 정한 근거

실제 시험 공간을 닮은 무작위 지도로 채점했다. 원통형 기둥만 있고 벽은 멀리 떨어진 공간이다.
설정을 고칠 때 보지 않은 새 지도 40개(2000~2039번)의 결과다.

| 센서 조합 | 도착 | 기둥에 닿음 | 멈춤 | 가장 작은 차체 여유 |
|---|---|---|---|---|
| 360도 라이다 (비교 기준, 사지 않음) | 39/40 | 0 | 1 | 0.10 m |
| **서보 ToF + 뒤 ToF (선택)** | **40/40** | **0** | **0** | **0.19 m** |
| 서보 ToF만 | 38/40 | 0 | 2 | 0.17 m |
| 고정 ToF 3개 | 38/40 | 1 | 1 | -0.14 m |

초음파 센서는 기존 시험 지도에서 비스듬한 벽을 못 봐 부딪혀서 후보에서 뺐다.
시뮬레이션 결과이므로 실제와 다를 수 있다. 가정은 7장에 적었다.

## 2. 두 가지 계획

| 역할 | 계획 A: 오렌지파이 5 (기본) | 계획 B: 노트북 (예비) |
|---|---|---|
| 두뇌 | 차에 실은 오렌지파이 5 | 책상 위 노트북 |
| 손발 | 아두이노 | ESP32 권장, 또는 아두이노와 블루투스 모듈 |
| 연결 | USB 케이블 | ESP32가 직접 만든 와이파이, 또는 블루투스 |
| 장점 | 차가 혼자 달린다. 와이파이 모듈이 있어 노트북으로 원격 접속해 화면을 볼 수 있다 | 계산이 가장 빠르다 |
| 약점 | 보드에서 계산 속도를 아직 재지 않았다. 라즈베리 파이보다 자료가 적다 | 무선 지연과 끊김이 생길 수 있다 |

두 계획의 계획 알고리즘 코드는 같다. 달라지는 것은 센서 값을 받고 명령을 보내는 연결 부분뿐이다.
우리 구조에서는 모터와 센서를 전부 아두이노가 맡으므로, 오렌지파이의 핀 제어 라이브러리가
라즈베리 파이와 다른 점은 거의 문제가 되지 않는다.

### 역할 나누기

| 담당 | 하는 일 | 주기 |
|---|---|---|
| 두뇌 | 센서 값으로 지도 갱신, 하이브리드 A\*, 경로 추종 | 계획 10 Hz, 추종 50 Hz |
| 마이크로컨트롤러 | 조향 서보와 모터 신호, ToF 두 개와 자이로 읽기, 센서 서보 돌리기, 엔코더 세기, 비상 정지 | 100 Hz 이상 |
| 둘 사이 | 두뇌는 속도와 조향각을 보내고, 마이크로컨트롤러는 센서 값과 센서 서보 각도를 올린다 | 50 Hz |

### 계획 B에서 주의할 것

- 학교나 집 공유기에 붙이지 않는다. 다른 기기가 많으면 끊기기 쉽다. ESP32가 스스로 와이파이를 만들고 노트북이 거기 접속한다.
- 명령이 일정 시간 안 오면 ESP32가 스스로 차를 세운다. 무선에서는 이 장치가 더 중요하다.

---

## 3. 준비물

"필요"는 그 계획에서 필요한 것, "-"는 필요 없는 것이다.
상태 열의 **확인**은 친구나 RC카에 이미 있을 수 있는 것, **실험 후**는 시뮬레이터 실험을 보고 정할 것이다.

| 분류 | 준비물 | A | B | 상태 |
|---|---|---|---|---|
| 차체 | 서보 조향 RC카 차체 | 필요 | 필요 | 확인 |
| 차체 | 구동 모터와 변속기 | 필요 | 필요 | 확인. 후진이 되는지 |
| 차체 | 조향 서보 | 필요 | 필요 | 확인 |
| 차체 | 별도 모터 드라이버 | 필요 시 | 필요 시 | 변속기 후진 방식 보고 결정 |
| 두뇌 | 오렌지파이 5, 메모리 16 GB, 와이파이 모듈 포함 | 필요 | - | 확보 |
| 두뇌 | 마이크로SD 카드 16~32 GB | 필요 | - | 필수. 내장 저장장치가 없고 M.2 슬롯은 와이파이 모듈이 씀 |
| 두뇌 | 방열판과 소형 팬 | 필요 | - | 필수. 사진상 칩에 방열판이 없음 |
| 두뇌 | 노트북 | 개발용 | 두뇌 | 확인 |
| 제어 | 아두이노 우노나 나노 | 필요 | 대안 | 확인 |
| 제어 | ESP32 보드 | - | 권장 | 계획 B 일 때만 |
| 제어 | 블루투스 모듈 HC-05 | - | 아두이노를 쓸 때 | 선택 |
| 제어 | USB 케이블, 필요하면 USB 허브 | 필요 | 개발용 | 필수 |
| 센서 | 레이저 ToF VL53L1X 2개 | 필요 | 필요 | 필수 |
| 센서 | 센서 회전용 소형 서보 1개 | 필요 | 필요 | 필수 |
| 센서 | 자이로 MPU6050 | 필요 | 필요 | 필수 |
| 센서 | 홀 센서와 작은 자석 | 필요 시 | 필요 시 | 실험 후 |
| 전원 | 구동용 배터리와 충전기 | 필요 | 필요 | 확인 |
| 전원 | 오렌지파이용 5 V 전원 | 필요 | - | 필수. 설명서 권장 전류 확인 |
| 전원 | ESP32용 5 V 전원 | - | 필요 | 변속기 전원 출력이나 작은 보조배터리 |
| 안전 | 모터 전원 차단 스위치, 퓨즈 | 필요 | 필요 | 필수 |
| 안전 | RC 조종기와 수신기 | 권장 | 권장 | 확인 |
| 기구 | 장착판, 점퍼선, 만능기판, 케이블타이 | 필요 | 필요 | 필수 |
| 기구 | 인두기와 납 | 필요 | 필요 | 학교에서 빌릴 수 있음 |
| 시험 | 멀티미터, 줄자, 각도기 | 필요 | 필요 | 확인 |
| 시험 | 원통형 기둥, 바퀴 띄울 받침대 | 필요 | 필요 | 필수. 기둥 굵기를 재 둘 것 |

### 준비물마다 알아둘 것

- **오렌지파이는 라즈베리 파이용 운영체제를 못 쓴다.** 오렌지파이 5 공식 우분투나 데비안 이미지를 권한다. M.2 에 꽂힌 와이파이 모듈 AP6275P 는 드라이버가 있어야 동작하는데, 공식 이미지가 지원할 가능성이 가장 크다. 다른 이미지를 쓰면 와이파이가 안 잡힐 수 있으니 설치 후 확인한다.
- **오렌지파이는 뜨거워지면 스스로 느려진다.** 하이브리드 A\*는 계산을 쉬지 않고 해서 열이 난다. 느려지면 계획이 늦어져 위험하므로 방열판과 팬을 단다.
- **전원 부족이 흔한 문제다.** 휴대폰 충전기로는 부족할 수 있다. 설명서의 권장 전원을 확인하고 넉넉한 어댑터나 보조배터리를 쓴다.
- **VL53L1X 두 개는 같은 I2C 주소로 나온다.** 각 센서의 XSHUT 핀으로 하나씩 켜서 주소를 바꾸면 분배기 없이 한 줄에 물릴 수 있다.
- **센서 서보는 방향마다 잠깐 멈췄다가 잰다.** 시뮬레이터는 서보가 정확한 각도에서 잰다고 가정한다. 실제 서보는 늦게 따라가고 흔들려서, 움직이면서 재면 장애물이 엉뚱한 곳에 찍힌다. 아두이노가 잰 값과 그때의 서보 각도를 함께 올려야 한다.
- **구동 모터는 브러시 모터가 낫다.** 센서 없는 브러시리스 모터는 아주 느린 속도에서 덜컥거린다.
- **변속기의 후진 방식을 꼭 확인한다.** RC카 변속기는 "브레이크, 중립, 다시 후진"을 거쳐야 뒤로 가는 제품이 많다.
- **실제 RC카는 너무 빠르다.** 시뮬레이터 최고 속도는 1.4 m/s다. 마이크로컨트롤러에서 최고 속도를 제한한다.
- **자이로는 빼면 안 된다.** 방향이 3도만 틀려도 5 m 앞은 26 cm 어긋나서 지도가 망가진다.
- **엔코더는 실제로 간 거리를 잰다.** 명령 속도에 시간을 곱하면 배터리 전압, 가속 지연, 바닥 상태에 따라 틀린다. 필요한지는 실험으로 정한다.
- **RC 조종기는 무선 비상 정지로 쓴다.** 컴퓨터가 멈춰도 사람이 바로 차를 세울 수 있다. 막다른 곳에 들어가면 사람이 꺼내는 것을 기본으로 한다.
- **보드와 모터 전원을 나눈다.** 모터가 돌 때 전압이 떨어져 보드가 꺼질 수 있다. 접지는 공통으로 연결한다.

### 싼 센서라서 약한 것과 대응

| 약점 | 대응 |
|---|---|
| 보는 거리가 8 m 에서 3 m 정도로 준다 | 천천히 달린다. 시험 공간을 작게 잡는다 |
| 한 번에 몇 방향만 본다 | 서보로 좌우 180도를 훑는다 |
| 가는 기둥을 늦게 보고 엉뚱한 곳에 찍는다 | 원뿔 끝 호 전체에 기록한다. 가장 작은 여유가 0.07 m 에서 0.19 m 로 늘었다 |
| 뒤가 안 보인다 | 뒤 ToF 1개. 막혔을 때만 느리게 후진한다 |
| 한 수평면만 본다 | 기둥은 센서 높이보다 키가 커야 한다 |
| 유리, 거울, 아주 검은 표면을 놓칠 수 있다 | 무광 기둥을 쓴다 |
| 막다른 곳 탈출이 느리고 벽에 붙는다 | 막다른 곳은 시험하지 않는다. 기능으로만 둔다 |

### 예산이나 필요 때문에 뺀 것

| 뺀 것 | 이유 |
|---|---|
| 360도 라이다 | 예산. ToF 2개와 서보로 대신한다 |
| 라즈베리 파이 | 오렌지파이 5 를 구할 수 있어서 |
| 고정 ToF 3개 | 옆을 못 봐서 무작위 지도에서 기둥에 닿았다 |
| 자이로 BNO055 | 예산. MPU6050으로 대신하지만 방향 오차가 조금 더 빨리 쌓인다 |
| GPS | 실내에서 못 쓴다 |
| 카메라 | 지금 알고리즘이 쓰지 않는다 |
| 초음파 센서 | 비스듬한 벽을 못 봐서 부딪혔고, 여러 개면 서로 간섭한다 |

---

## 4. 아직 정할 것

| 정할 것 | 정하는 방법 |
|---|---|
| 엔코더 필요 여부 | 시뮬레이터에서 위치 추정을 명령 속도와 자이로로 바꿔 버티는지 본다 |
| 오렌지파이 5 로 충분한지 | 보드에서 시뮬레이터 시험과 벤치마크를 돌린다 (6장 2단계) |
| 모터 드라이버 추가 여부 | 친구 RC카 변속기가 후진을 바로 할 수 있는지 확인한다 |
| 실제 기둥 굵기 | 재서 알려주면 무작위 지도를 그 굵기로 다시 만들어 채점한다 |
| 블루투스인지 ESP32 와이파이인지 | 계획 B일 때만 |

## 5. 친구에게 물어볼 것

부품 윗면 글자나 라벨이 보이는 사진이 가장 확실하다.

1. 아두이노 모델, 그리고 ESP32가 있는지
2. 오렌지파이용 전원 어댑터와 방열판, 팬이 있는지
3. RC카 차체 길이, 폭, 앞뒤 바퀴 사이 거리, 최대 조향각
4. 변속기와 모터 모델
5. RC 조종기와 수신기가 있는지
6. 자이로 센서나 거리 센서 중 이미 가진 것이 있는지

## 6. 만드는 순서

한 번에 다 붙이면 문제가 생겼을 때 원인을 찾을 수 없다. 한 단계씩 확인하고 넘어간다.

| 단계 | 할 일 | 통과 기준 |
|---|---|---|
| 1 | 친구 답을 받아 차체 사양을 시뮬레이터에 넣는다 | 실제 차 크기로도 무작위 지도를 통과 |
| 2 | 오렌지파이에 운영체제와 파이썬을 깔고 시뮬레이터를 돌린다 | 시험 통과, 계획 한 주기가 제시간 안에 끝남 |
| 3 | 위치 추정 실험으로 엔코더 필요 여부를 정하고 부품을 구한다 | 준비물 목록 확정 |
| 4 | 아두이노로 조향 서보와 모터를 손으로 조종한다 | 연결을 끊으면 차가 멈춤 |
| 5 | 위치 추정을 확인한다 | 바닥에 네모를 그리며 달려 추정 위치와 실제 위치를 비교 |
| 6 | ToF 와 센서 서보를 붙이고 차를 손으로 밀며 지도를 본다 | 화면의 지도가 실제 기둥 위치와 맞음 |
| 7 | 계획 없이 정해진 경로만 따라간다 | 추종기가 경로를 벗어나지 않음 |
| 8 | 전체 알고리즘을 느린 속도부터 돌린다 | 부딪히지 않고 목적지 도착 |

2단계에서 돌릴 명령:

```
python -m tests.test_hybrid
python run.py --scenario random --seed 2005 --sensor tof_sweep_rear --headless
```

두 번째 출력의 `plan_ms_mean`, `plan_ms_p95` 가 계획 한 주기에 걸린 시간이다.
PC 에서는 평균 수십 ms 였다. 계획 주기가 0.1 초이므로 이보다 충분히 짧아야 한다.

## 7. 시뮬레이터와 실제의 대응

| 시뮬레이터 | 실제 |
|---|---|
| 센서 조합 tof_sweep_rear | 서보 위 ToF 1개와 뒤 ToF 1개 |
| 차가 믿는 위치 | 자이로와 엔코더, 또는 명령 속도로 추정한 위치 |
| 차량 명령 실행 | 아두이노가 서보와 변속기에 보내는 신호 |
| 정답 지도 | 실제 세계. 알고리즘은 원래 이것을 못 본다 |

시뮬레이션이 가정한 것 (실제와 다를 수 있다):

- ToF 원뿔 27도, 거리 3 m, 오차 2 cm 와 거리의 1%
- 센서 서보가 정확한 각도에서 잰다. 0.1 초에 세 방향, 15 도 간격
- 위치 오차가 이동 거리의 0.6% 수준. 엔코더가 있을 때 수준이다
- 기둥 반지름 5~30 cm, 달리는 공간 가로세로 5~10 m

실물로 옮기면 새로 챙길 것이 있다.

- **조향 보정.** 서보 신호와 실제 바퀴 각도의 관계, 중앙값, 최대 각도를 잰다.
- **센서 위치 보정.** 실제 장착 위치를 재서 시뮬레이터 설정과 맞춘다.
- **계산 지연.** 계획하는 동안에도 차는 움직인다. 계획이 끝났을 때의 위치를 예측해서 계획을 시작한다.
- **지도 크기.** 시뮬레이터는 32 m × 32 m 고정 지도를 쓴다. 실제로는 시험 공간에 맞춰 줄인다.
