StarCoder14/Auto_DRIVING/HANDOFF.md

# HANDOFF — 이어서 개발할 때 알아둘 것

## 실행

```bash
pip install -r requirements.txt                 # numpy, matplotlib
python run.py                                   # 창으로 보기 (하이브리드 A*)
python run.py --planner tangent                 # 예전 접선 그래프 계획기
python run.py --scenario trap --no-graph        # 다른 시나리오, 가볍게
python run.py --bench                           # 전 시나리오 성능 측정
python run.py --record out.mp4 --speed 3        # 동영상 저장 (ffmpeg 필요)
python run.py --snapshot shot.png --snapshot-at 8
python run.py --list
python -m tests.test_hybrid                     # 하이브리드 A* 시험 (몇 초)
python -m tests                                 # 시험 전체 (접선 그래프 시험 때문에 수십 분)
```

기본 계획기는 **하이브리드 A\*** 다 (`rccar/hybrid.py`, `rccar/hybrid_sim.py`).
접선 그래프는 비교와 발표용으로 남겨 두었다.

현재 상태 (충돌은 **차체 사각형 전체** 기준으로 잰 값):

| 시나리오 | 하이브리드 A\* | 차체 최소 여유 | 접선 그래프 | 차체 최소 여유 |
|---|---|---|---|---|
| pillars | 18.5 s | 0.62 m | 25.0 s | 0.52 m |
| walls | 19.1 s | 0.44 m | 17.6 s | 0.65 m |
| narrow | 8.8 s | 0.30 m | 12.7 s | 0.70 m |
| trap | 20.9 s | 0.28 m | 34.2 s | 0.03 m |
| forest | 21.6 s | 0.29 m | 40.8 s | -0.05 m (접촉) |

하이브리드 A\*는 `forest` 무작위 배치 여섯 개에서도 전부 도착, 여유 0.18 m 이상.
계획 주기 평균은 부하 없는 측정에서 하이브리드 19~63 ms, 접선 그래프 72~624 ms.

---

## 파일 구조

프로젝트 루트가 곧 패키지 루트다. 모든 실행은 루트에서 한다.

```
run.py            CLI. 진입점. --planner hybrid|tangent
rccar/
  hybrid.py       하이브리드 A*, 거리장, 웨이브프런트 휴리스틱, 차체 원 모델  ← 기본 계획기
  hybrid_sim.py   격자 갱신(numpy), 재계획 조건, 전진/후진 추종, 예측 정지
  geometry.py     접점·공통접선·호·충돌·볼록껍질   (순수 함수, 단위 테스트 가능)
  obstacles.py    둥근 볼록껍질, 부풀림, 병합
  planner.py      접선 그래프 + 지연평가 A*        ← 알고리즘의 심장
  perception.py   클러스터링, 형상 추정, 추적
  grid.py         점유 격자 + 비상용 격자 A*
  vehicle.py      자전거 모델
  controller.py   순수 추종
  simulator.py    3중 루프 + 상태 기계             ← 튜닝은 대부분 여기
  scenarios.py    시험 환경 5개
  viz.py          matplotlib 시각화
tests/
  test_hybrid.py    하이브리드 A*: 곡률 한계, 진행 방향, 차체 여유, 좁은 틈, 골목, 후진
  test_geometry.py  기하 함수를 무작위 입력 수만 건으로 검증
  test_planner.py   나온 경로가 실제로 안전한지 무작위 환경으로 검증
ALGORITHM.md      알고리즘 설명 (코드 주석이 이 문서의 절 번호를 인용함)
알고리즘_정리.md   발표용 요약
```

`ALGORITHM.md`를 먼저 읽으면 코드가 훨씬 빨리 이해된다. 각 함수의 docstring이
문서의 절 번호를 그대로 참조한다.

---

## 하이브리드 A\*로 옮기면서 실제로 터진 것들

### H1. 충돌 판정이 뒷바퀴 축 한 점만 본다 — `simulator.step`

`world.min_distance(뒷바퀴 축) < body_radius * 0.55` 가 충돌 판정이다.
차 앞머리가 기둥에 파고들어도 축이 멀면 "충돌 없음"이 된다.
예전 계획기는 이 판정으로 "전 시나리오 충돌 0건"이었지만, 차체 사각형으로
다시 재니 `forest`에서 기둥에 5 cm 파고들었고 `trap`에서는 3 cm까지 붙었다.
**성능을 비교할 때는 반드시 차체 전체로 잴 것.** 공식 판정은 아직 그대로다.

### H2. 휴리스틱이 얇은 벽을 뚫는다 — `hybrid.wavefront`

여덟 방향을 연달아 퍼뜨린 뒤 막힌 칸을 한 번만 막으면, 그 사이에 값이 한 칸
두께 벽을 타고 건너편으로 샌다. ㄷ자 골목 안에서 목적지까지가 벽을 통과한 직선
거리로 나왔고, 탐색은 벽을 향해 헤매다 확장 상한에 걸려 실패했다.
**방향 하나를 퍼뜨릴 때마다 막아야 한다.** `test_wavefront_does_not_leak` 가 지킨다.

### H3. 여유에 비례한 감속이 안전은 못 지키고 시간만 먹었다 — `SegmentTracker`

처음엔 경로 옆 여유가 작으면 세게 감속했다. 벽을 따라 나란히 달릴 때마다 느려져서
`walls`가 24.7 초였다. 감속을 사실상 끄자 19.1 초가 됐고 차체 여유는 0.21 에서
0.44 m 로 오히려 늘었다. 부딪힘은 `_control`의 예측 정지(차체 기준 제동 거리 검사)가
막는다. 감속 계수를 다시 세게 올리지 말 것.

### H4. 못 맞힌 라이다 광선을 '비었음'으로 기록하면 안 된다 — `integrate_fast`

라이다는 '아무것도 없음'과 '반사 누락(dropout)'을 똑같이 inf 로 준다.
비었다고 기록하면 실제 장애물 칸이 한 번에 문턱 아래로 지워진다.

### H5. 컴퓨터가 절전에 들어가면 시간 측정이 망가진다

벽시계로 재므로 계획 한 번이 30 분으로 찍힌다. 경로와 주행 결과는 그대로라
도착·여유·주행 시간은 믿어도 되지만, 계획 시간 숫자는 버리고 다시 잴 것.
측정을 여러 개 동시에 돌려도 같은 일이 생긴다.

---

## 접선 그래프 계획기를 만들면서 터진 것들 (다시 건드릴 때 주의)

### 1. 오목한 물체를 볼록껍질로 감싸면 안 된다 — `perception.split_convex`

ㄷ자 벽 세 개를 한 묶음으로 잡아 볼록껍질을 씌우니 **입구가 메워져서, 그 안에
있던 자동차가 "장애물 내부"로 판정**됐다. 실제로 재현된 문제다.

해결: IEPF로 볼록 조각으로 쪼갠다. 조각들이 끝점을 공유하므로 공유 꼭짓점의
바깥 호가 두 조각 경계 위에 정확히 놓여, 모서리 도는 경로가 공짜로 생긴다.

**이 함수 건드리면 `trap` 시나리오가 즉시 깨진다.**

### 2. 계획용 반경 ≠ 안전용 반경 — `simulator.rho` vs `rho_hard`

부풀린 영역 침범을 "위반"으로 취급하니 탈출↔주행이 무한 토글하며 그 자리에서
진동했다. 부풀림은 계획상의 여유일 뿐이다. 실제 위험선(`rho_hard`)은 따로.

여기에 **탈출을 시작하면 최소 시간 유지**(`recover_time`)가 없으면 여전히
한계 순환에 빠진다. 같은 자리에서 반복되면 후진 시간을 늘리는 로직도 필수.

### 3. 비상 정지는 복구로 이어져야 한다 — `simulator._sense_and_plan`의 `nose_blocked`

estop이 속도만 0으로 만들고 끝나면, 코를 박은 차가 **영구 동결**된다.
`nose_blocked` 조건이 없으면 `pillars`가 t=12초에서 그대로 멈춘다.
그리고 후진 중에는 전방 정지 조건을 걸면 안 된다.

### 4. `rho`의 하한은 최소 회전 반경 × 1.6

`× 1.0`으로 두면 핸들 끝까지 꺾어야 겨우 도는 호가 생겨 추종 오차가 그대로
침범이 된다. `turn_slack` 파라미터.

### 5. 호도 반드시 충돌 검사 — `planner.evaluate`

직선만 검사하고 호를 빠뜨리는 게 흔한 실수다. 자기가 속한 덩어리도 검사
대상이어야 한다(꼭짓점 원의 '안쪽' 호는 도형 내부를 지난다).

### 6. 여유(clearance)를 잴 때 자기 장애물은 제외

호는 정의상 부풀린 경계에 붙어 있어 여유가 항상 0이다. 그대로 쓰면 모든 호가
최대 벌점을 받는다. `_cost(exclude_gids)` 참조.

---

## 성능

지연 평가(lazy A\*)가 핵심이다. 엣지 5,709개 중 **평균 25개만** 실제로
충돌 검사한다. **2,253 ms → 24 ms (약 90배).** 경로 비용은 전수 검사와
소수점까지 동일(32.02)했으므로 근사가 아니다.

원리: 그래프 구성 시엔 회전 방향 일관성만 보고(부호 하나), 하한 비용(길이)으로
큐에 넣는다. 꺼낼 때 검사하고, 실제 비용이 하한보다 크면 고쳐서 다시 넣는다.

**`_cost`에 길이보다 작아지는 항을 추가하면 이 성질이 깨진다.** 벌점은 항상
0 이상이어야 한다.

---

## 다음에 할 만한 것 (우선순위 순)

하이브리드 A\* 기준:

1. **차체 전체 충돌 판정을 시뮬레이터 공식 지표로** (H1). 지금은 측정 스크립트에만 있다.
2. **막다른 골목에서 가끔 탐색이 1초를 넘는다.** `trap`에서 최대 1.2~1.6 초가 나왔다.
   휴리스틱을 계획마다 새로 만들지 말고 지도가 크게 바뀔 때만 다시 만들거나,
   목적지가 같으면 지난 탐색 결과를 재사용한다 (D\* Lite 방향).
3. **`walls`는 아직 접선 그래프보다 1.5 초 느리다.** 벽 끝을 도는 곡선이 보수적이다.
   `turn_slack`(1.15)이나 `w_steer`를 조정해 볼 것.
4. **Reeds-Shepp 직결** — 지금 직결 시도는 전진 '한 번 꺾고 곧장'뿐이다.
5. **동적 장애물** — 점유 격자에 시간 감쇠, 계획에 시간 축.

접선 그래프 기준 (예전 목록):

1. **`forest` 계획 시간 183 ms → 100 ms 이하**
   `planner._build`의 원-원 루프를 numpy로 벡터화. 지금은 파이썬 이중 루프다.
   또는 `max_circles`(24), `plan_radius`(10 m)를 더 줄인다.

2. **겹친 두 덩어리의 경계를 이어 도는 경로**
   지금은 경계 교차점에 노드가 없어서 못 만든다. 병합(2.5)과 격자 폴백(5장)이
   덮고 있다. 제대로 하려면 두 부풀린 경계의 교차점을 노드로 추가해야 한다.
   `ObstacleGroup.outline()`을 따라가며 상대 그룹의 `distance_many` 부호가
   바뀌는 지점을 이분법으로 찾으면 된다.

3. **`perception.py`, `grid.py`, `controller.py` 시험 추가**
   `tests/`에 기하와 계획기 시험은 들어왔지만 이 셋은 아직 비어 있다.
   특히 `split_convex`는 `trap` 시나리오 전체가 걸려 있는데 시험이 없다.

4. **동적 장애물** — 추적기에 등속 모델 칼만 필터, 계획에 시간 축.

5. **Reeds-Shepp** — 접선 그래프에서는 후진이 탈출 반응 동작일 뿐 계획되지 않는다.

---

## 튜닝 포인트

하이브리드 A\*:

| 파라미터 | 위치 | 효과 |
|---|---|---|
| `hard_margin` | `HybridParams` | 크게 → 안전하지만 좁은 틈 못 감 (지금 0.7 m 틈까지 통과) |
| `soft_margin`, `w_clear` | `HybridParams` | 크게 → 장애물에서 멀리 돌아감 |
| `turn_slack` | `HybridParams` | 크게 → 완만한 곡선, 좁은 곳에서 유턴 어려움 |
| `rev_mult`, `switch_cost` | `HybridParams` | 크게 → 후진을 덜 씀 |
| `h_weight` | `HybridParams` | 크게 → 빠르지만 덜 최단. 3.0 은 오히려 느렸다 |
| `max_expand` | `HybridParams` | 계산 시간 상한. 실패하면 이 시간만큼 쓴다 |
| `replan_period`, `adopt_ratio` | `HybridConfig` | 경로를 얼마나 자주 다시 보고 얼마나 쉽게 갈아탈지 |
| `clear_v0`, `clear_gain` | `SegmentTracker` | 여유 감속. 세게 걸지 말 것 (H3) |

접선 그래프:

| 파라미터 | 위치 | 효과 |
|---|---|---|
| `turn_slack` | `SimConfig` | 크게 → 안전하지만 좁은 곳 못 감 |
| `w_clear`, `clear_ref` | `PlannerParams` | 크게 → 통로를 피해 돌아감 |
| `hysteresis` | `SimConfig` | 작게 → 경로를 잘 안 바꿈 (진동 억제) |
| `ld_max`, `k_lookahead` | `ControllerParams` | 크게 → 부드럽지만 코너 많이 잘라먹음 |
| `deadlock_window` | `SimConfig` | 작게 → 격자 폴백이 자주 개입 |
| `min_span_deg` | `perception` | 원으로 인정하는 최소 호 폭 (기본 90°) |

경로가 벽에 붙으면 `w_clear`를 올리고, 좁은 곳을 못 지나가면 `turn_slack`을
내린다. 차가 갈팡질팡하면 `hysteresis`를 내린다.

---

## 하드웨어로 옮길 때만 참고

시뮬레이터의 인터페이스는 실물과 1:1로 대응된다.

- `Lidar.scan()` → 실제 라이다 드라이버
- `Vehicle.odom` → 휠 엔코더 + IMU 융합 결과
- `Vehicle.step()` → 조향/구동 명령 퍼블리시
- `World` → 버린다 (정답을 아는 유일한 파일)

`world.py`만 갈아끼우면 나머지는 그대로 돌아간다.

**실제 차 치수는 `rccar/car_specs.py` 한 곳에만 적는다** (2026-10-19).
cm 로 적으면 `run_robot.py`, `run.py --car ours`, 처음 기하 모델이 따라간다. 안 잰 값은 시뮬레이터 기본 차 값을 쓴다.
차체가 뒷바퀴 축에서 앞뒤로 얼마나 튀어나왔는지, 센서 위치는 `VehicleParams` 의
`rear_overhang_m`, `front_sensor_x_m`, `rear_sensor_x_m` 에서만 계산한다. 예전엔 같은 식이 다섯 파일에 복사돼 있었다.
아무것도 안 재면 예전과 결과가 완전히 같다 (`tests/test_car_specs.py` 가 지킨다).

**센서는 앞 ToF 하나뿐이다** (2026-10-19 결정). 서보에 올려 좌우로 훑고, 뒤 센서는 없다. 세 루프의 주기(10/50/100 Hz)도
그대로 유지할 것.
