StarCoder14/Auto_DRIVING/ALGORITHM.md

# 지도 없이 스스로 길을 찾는 자율주행 알고리즘

이 문서는 알고리즘만 다룬다. 하드웨어 선정과 배선은 범위 밖이다.

같은 폴더의 파이썬 구현이 이 문서를 그대로 따른다. 각 절의 번호는 코드의
주석에서 그대로 인용된다.

---

## 1. 문제 정의

이 자동차는 지도를 갖고 있지 않다. 아는 것은 두 가지뿐이다.

- 목적지가 어느 방향으로 얼마쯤 떨어져 있는지
- 지금 센서에 보이는 것

안개 낀 벌판을 걷는 사람과 같은 상황이다. 나침반으로 방향은 알지만 앞은
몇 미터밖에 안 보인다.

이런 상황에서 완벽한 경로를 한 번에 짜는 것은 불가능하다. 그래서 이
알고리즘의 원리는 하나다.

> **보이는 데까지 계획해서 조금 가고, 새로 보이는 것이 생기면 계획을 다시
> 짜고, 또 조금 간다.**

이 과정을 1초에 열 번 반복한다. 알고리즘 전체가 이 반복 위에 올라가 있다.

---

## 2. 세계를 어떻게 표현하는가

### 2.1 자동차를 점으로 만들기

자동차는 폭이 있다. 장애물을 피할 때 차의 크기를 매번 고려하면 계산이
복잡해진다. 그래서 반대로 한다. **장애물을 실제보다 크게 부풀린다.**

부풀리는 양은 세 가지를 더한 값이다.

- 차체 외접원 반지름
- 센서 측정 오차
- 차가 계획대로 정확히 못 가는 정도 (추종 오차)

이렇게 하면 부풀린 도형 바깥에 차의 중심만 있으면 안전이 보장된다. 즉
**이후 모든 계산에서 자동차를 크기 없는 점으로 취급할 수 있다.**

여기에 조건이 하나 더 붙는다.

> **부풀린 반지름은 차의 최소 회전 반경보다 넉넉히 커야 한다.**

RC카는 앞바퀴를 꺾어 도는 방식이라 아무리 핸들을 끝까지 꺾어도 일정 반경
이하로는 못 돈다. 그보다 작은 곡선을 계획해봐야 실행할 수 없다.

주의할 점은 **최소 회전 반경과 '같게' 두면 안 된다**는 것이다. 그러면 핸들을
끝까지 꺾어야 겨우 도는 호가 되고, 조금의 추종 오차도 그대로 침범으로
이어진다. 구현에서는 최소 회전 반경의 1.6배를 하한으로 쓴다.

### 2.2 계획용 반경과 안전용 반경은 다르다

이것이 실제로 만들어 보기 전에는 잘 안 보이는 부분이다.

부풀린 영역은 **경로를 그릴 때 쓰는 여유**이지, 넘으면 사고가 나는 선이
아니다. 코너를 조금 잘라먹으면 부풀린 영역 안으로 들어가는 일은 늘 생긴다.
그것을 위반으로 취급하면 "탈출 → 주행 → 다시 침범 → 탈출"이 무한히 반복되며
차가 그 자리에서 진동한다.

그래서 두 개의 반경을 쓴다.

| 이름 | 값 | 의미 |
|---|---|---|
| `rho` | 계획용, 넉넉함 | 경로는 이 바깥으로 그린다 |
| `rho_hard` | 차체 + 센서 오차 | 이 선을 넘으면 그때 탈출한다 |

그리고 탈출을 시작하면 **최소 시간은 유지한다.** 10 cm 물러나자마자 주행으로
돌아가면 같은 자리로 다시 밀고 들어간다.

### 2.3 장애물의 형태

장애물 하나를 이렇게 표현한다.

> **크기가 똑같은 원 여러 개를 이어붙인 덩어리**

만드는 방법은 이렇다.

1. 센서에 잡힌 점들을 고무줄로 감싸듯 볼록한 테두리를 만든다.
2. 테두리의 꼭짓점마다 똑같은 크기의 원을 하나씩 놓는다.
3. 이 원들과, 원들 사이를 잇는 직선이 이 장애물의 바깥 경계가 된다.

이 표현이 좋은 이유가 넷이다.

- **점이 하나면 그냥 원**이 된다. 기둥 같은 단순한 물체는 원 하나로 처리된다.
- **벽처럼 긴 물체는 가늘고 긴 덩어리**가 된다. 벽을 원 하나로 감싸면 반지름
  몇 미터짜리 거대한 원이 생겨 지도의 절반이 막히는데, 그런 일이 없다.
- **가까이 있는 장애물끼리 겹치면 점 집합을 합치기만** 하면 자동으로 하나의
  덩어리가 된다.
- **모든 원의 크기가 같다.** 크기가 같으면 원과 원 사이의 접선을 구하는
  계산이 극도로 단순해진다. 두 중심을 이은 선을 옆으로 미는 것으로 끝난다.

결과적으로 이 세계에는 두 종류의 선분만 존재한다. **직선**과 **크기가 똑같은
원의 호**. 계산해야 할 기하가 딱 이 둘로 고정된다.

### 2.4 오목한 물체는 반드시 쪼개야 한다

**이 절을 빠뜨리면 큰 사고가 난다. 실제로 재현되는 문제다.**

볼록껍질은 오목한 물체를 표현하지 못한다. ㄷ자 벽 세 개를 한 묶음으로 잡아
볼록껍질을 씌우면 **입구가 메워진다.** 그러면 그 안에 서 있던 자동차가
"장애물 내부에 있다"고 판정되고, 아무 데도 갈 수 없게 된다.

해결은 이렇다.

1. 센서 점렬을 훑으며, 양 끝을 이은 직선에서 가장 많이 벗어난 점을 찾는다.
2. 벗어난 정도가 기준(8 cm)을 넘으면 그 점에서 자른다.
3. 벗어남이 기준 이하가 될 때까지 재귀적으로 반복한다.

ㄷ자 벽은 세 조각으로 쪼개지고, 각 조각은 볼록하다. 입구는 메워지지 않는다.

여기서 중요한 성질이 하나 나온다. **쪼갠 조각들은 끝점을 공유한다.** 공유
꼭짓점에 놓인 원의 바깥 호는 두 조각 경계 위에 정확히 놓이므로, 모서리를
돌아가는 경로가 아무 추가 처리 없이 자연스럽게 생긴다.

### 2.5 병합할 때는 빈 공간을 삼키지 않도록

겹치는 장애물은 하나로 합쳐야 한다. 그런데 2.4에서 쪼갠 조각들을 다시 합치면
입구가 도로 메워진다.

그래서 규칙을 하나 둔다.

> **합쳤을 때 '이미 가봐서 비어 있다고 아는 공간'을 삼키게 되면, 합치지
> 않는다.**

- 두 기둥이 실제로 겹쳐 있으면 → 사이 공간은 애초에 갈 수 없다 → 합친다
- ㄷ자 벽 조각들 → 입구는 이미 지나온 빈 공간이다 → 합치지 않는다

빈 공간 여부는 2.6의 격자 지도로 판단한다.

### 2.6 격자 지도 병행

위와 별개로, 주변을 5~12 cm 정사각형으로 잘라 각 칸이 "비었음 / 막혔음 /
모름" 중 무엇인지 기록하는 격자 지도를 계속 유지한다.

용도는 세 가지다. 2.5의 빈 공간 판정, 5장의 탈출용 경로, 그리고 아직 안 가본
영역을 알아내는 것.

---

## 3. 경로를 어떻게 찾는가

### 3.1 왜 접선과 원호인가

바닥에 기둥을 세우고, 기둥 양옆에 못을 하나씩 박은 뒤 고무줄을 건다. 고무줄은
기둥에 막혀 이런 모양이 된다.

**한쪽 못에서 기둥까지 팽팽한 직선 → 기둥 표면에 감김 → 반대쪽 못까지 다시 직선**

고무줄은 항상 최단 경로를 택한다. 즉 **장애물을 피하는 최단 경로는
직선-곡면-직선**이고, 이건 취향이 아니라 증명된 사실이다.

여기서 직선은 반드시 **접선**이다. 접선은 부딪히지 않는 선 중 가장 안쪽
선이기 때문이다. 더 안으로 가면 충돌이고, 더 바깥은 돌아가는 것이다.

### 3.2 필요한 계산 세 가지

**첫째, 점에서 원으로 그은 접선의 접점.**

내 위치와 원의 중심을 잇고, 반지름과 중심까지의 거리로 직각삼각형을 만들면
접선이 벌어진 각도가 나온다. 중심 방향에서 그 각도만큼 양쪽으로 벌리면 접점
두 개다.

```
d = |P - c|
beta  = atan2(P - c)
alpha = acos(r / d)
T± = c + r * (cos(beta ± alpha), sin(beta ± alpha))
```

한쪽은 시계 방향으로 돌 때 쓰는 접점이고, 다른 쪽은 반시계 방향으로 돌 때
쓰는 접점이다. **이 대응 관계를 기억해야 한다.** 나중에 접점을 잘못 조합하는
문제를 막아준다.

2차방정식을 풀지 않으므로 점이 원에 아주 가까워도 수치적으로 안정적이다.
`acos`의 인자는 반드시 [-1, 1]로 잘라야 한다.

**둘째, 원과 원 사이의 접선.**

모든 원의 크기가 같으므로, 두 중심을 이은 선을 반지름만큼 옆으로 평행 이동한
것이 곧 외접선이다. 내접선은 두 중심 거리가 지름보다 클 때만 존재한다.

**셋째, 원 위 두 점을 잇는 호.**

여기서 주의할 점이 있다. **짧은 쪽 호를 고르면 안 된다.** 반드시 지정된 회전
방향(시계 또는 반시계)을 따라가야 한다. 짧은 쪽을 고르면 장애물을 관통하는
경로가 나온다.

### 3.3 노선도를 만든다

> **갈 수 있는 지점을 전부 모아 지하철 노선도를 그리고, 최단 경로를 찾는다.**

갈림길을 하나씩 따라가면 장애물 n개에 경로가 2의 n제곱 개로 폭발한다.
장애물 20개면 100만 개다. 1초에 열 번 계산해야 하는데 불가능하다.

**역(node)을 정한다.** 출발점, 목적지, 그리고 모든 접점이다. 접점은 위치만이
아니라 **어느 원의 어느 회전 방향에 속하는지**까지 함께 기록한다. 같은
위치라도 회전 방향이 다르면 다른 역이다. 이 정보 덕분에 접점을 잘못 조합해
원을 뚫는 경로가 애초에 만들어지지 않는다.

**노선(edge)을 긋는다.** 전부 방향이 있다.

- **직선**: 생성된 접선 그 자체만. 모든 노드 쌍을 잇지 않는다. 한 접선 선분은
  진행 방향에 따라 회전 방향이 반대가 되므로 서로 다른 두 개의 방향 엣지를
  만든다.
- **호**: 같은 원, 같은 회전 방향에서 각도상 **이웃한** 노드끼리만. A→C를 직접
  잇지 않아도 A→B→C로 같은 비용이 나오므로 결과는 같고, 호 엣지 수가 n제곱에서
  n으로 줄어든다.

**반드시 지켜야 할 것 둘.**

- 충돌 검사는 **직선이 아니라 선분** 기준이다. 무한히 뻗은 직선으로 검사하면
  옆으로 한참 비껴 있는 장애물까지 피하게 되어 차가 이상하게 돌아간다.
- **호 구간도 충돌 검사를 해야 한다.** 원 주위를 도는 중에 다른 장애물에
  부딪힐 수 있다. 자기 자신이 속한 덩어리도 검사 대상이다. 꼭짓점 원의 '안쪽'
  호는 도형 내부를 지나므로 여기서 걸러진다. 직선만 검사하고 호를 빠뜨리는
  실수가 흔하다.

**최단 경로를 찾는다.** 지하철 앱이 하는 일과 정확히 같은 문제다. A*를 쓰면
된다.

### 3.4 지연 충돌 검사

엣지가 수천 개인데 전부 미리 충돌 검사하면 한 번 계획에 2초가 넘어간다.

그래서 그래프를 만들 때는 **회전 방향 일관성만** 본다. 이건 부호 하나 보는
것이라 거의 공짜다. 충돌 검사와 정확한 비용은 A\*가 그 엣지를 **실제로 꺼낼
때** 계산한다.

- 하한 비용(길이)으로 먼저 우선순위 큐에 넣는다
- 꺼낼 때 검사한다. 부딪히면 버린다
- 실제 비용이 하한보다 크면 고쳐서 다시 넣는다

하한이 실제 비용을 넘지 않으므로 결과는 전수 검사와 **완전히 동일하다.**

측정 결과: 엣지 5,709개 중 평균 25개만 검사됐고, 계획 시간이 **2,253 ms에서
24 ms로 약 90배 빨라졌다.** 경로 비용은 32.02로 전수 검사와 소수점까지 같았다.

### 3.5 무엇을 "좋은 경로"로 볼 것인가

거리만 기준으로 하면 문제가 생긴다. **최단 경로는 장애물에 최대한 딱 붙어서
지나간다.** 붙을수록 짧으니 당연하다. 그런데 오차가 조금만 있으면 그대로
충돌이다.

그래서 네 가지를 함께 따진다.

| 항목 | 의미 |
|---|---|
| 길이 | 짧을수록 좋다 |
| 여유 | 좁은 통로를 지나는 구간에 벌점 |
| 꺾임 | 구간이 바뀔 때마다(핸들을 꺾어야 하니까) 벌점 |
| 미지 영역 | 아직 안 가본 곳을 지나는 구간에 약간의 벌점 |

여유를 잴 때 한 가지 요령이 있다. **지금 돌고 있는 그 장애물은 제외한다.**
호는 정의상 부풀린 경계에 붙어 있어서(그 여유가 곧 `rho`다) 항상 0으로
나오기 때문이다. 실제로 위험한 것은 **옆에 있는 다른 장애물까지의 거리**,
즉 통로 폭이다.

이 네 항목의 비중이 차의 성격을 결정한다. 여유 벌점을 높이면 조심스럽게
돌아가고, 낮추면 과감하게 붙는다. **실제 튜닝 작업의 대부분이 이 숫자를
만지는 일이다.**

아직 보지 못한 영역은 일단 "비어 있다"고 낙관적으로 가정한다. 가보고 막혀
있으면 그때 다시 계획한다.

### 3.6 경로를 쉽게 바꾸지 않는다

1초에 열 번 계획을 다시 짠다. 그런데 왼쪽으로 도는 길과 오른쪽으로 도는 길의
비용이 비슷하면, 센서 노이즈만으로 매번 답이 바뀐다. 차는 갈팡질팡하다 멈춘다.

> 새 경로가 지금 경로보다 **확실히**(10% 이상) 좋을 때만 바꾼다.
> 단, 지금 경로가 막혔으면 무조건 바꾼다.

### 3.7 출발점이 부풀린 영역 안에 있을 때

2.2에서 말했듯 이건 정상 상황이다. 그런데 이 상태로 계획하면 출발점에서
나가는 모든 선분이 "충돌"로 판정되어 경로가 하나도 안 나온다.

해결: **출발점이 이미 안에 들어와 있는 덩어리는, 출발점에서 나가는 엣지에
한해 충돌 검사를 면제한다.** 지금 그 안에 있으니까 나가는 것은 허용해야 한다.

---

## 4. 센서를 어떻게 다루는가

실제로 만들면 여기가 가장 어렵다.

### 4.1 점을 묶는다

라이다는 거리가 멀수록 점 사이 간격이 벌어진다. 그래서 "몇 cm 이내면 같은
물체"라는 고정된 기준을 쓰면 안 된다. **거리에 비례해 기준을 늘려야** 한다.

```
임계값 = d0 + 거리 × 각분해능 × k        (k는 2~3)
```

### 4.2 뒷면을 추측하지 않는다

센서는 빛이 닿는 앞면만 본다. 반쪽만 보고 전체 모양을 알아맞혀야 한다.

문제는 조금만 보였을 때다. 살짝 휜 호를 보면 "반지름 50미터짜리 거대한 원의
일부"라고 판단해버린다. 그러면 로봇 눈에는 지도 절반이 장애물이 된다.

그래서 이렇게 나눈다.

- **충분히 넓게 보였을 때만**(대략 90도 이상) 원이라고 추정한다.
  피팅 잔차가 작고, 반지름이 상식적이어야 한다는 조건도 함께 본다.
- 조금만 보였으면 추정하지 않고, **보인 점들을 2.4의 방식으로 쪼개서**
  그대로 쓴다.

보이지 않는 뒷면은 "모르는 영역"으로 남겨둔다. 차가 다가가면서 저절로
채워진다. 억지로 추측하는 것보다 훨씬 안전하다.

### 4.3 같은 물체를 기억한다

센서 노이즈 때문에 가만히 있는 기둥도 매 순간 중심이 몇 cm씩 흔들린다. 그대로
두면 경로가 계속 떨린다.

그래서 이번에 본 물체와 저번에 본 물체를 짝지어 "같은 것"으로 묶고, 점들을
누적한다. 누적된 점은 복셀 격자로 솎아 개수를 제한한다.

물체를 지우는 기준도 중요하다.

- **시야 안에 있는데 여러 번 연속으로 안 보이면** 지운다. 잘못 봤거나 치워진
  것이다.
- **시야 밖으로 나갔으면 절대 지우지 않는다.** 안 보인다고 없어진 게 아니다.

### 4.4 내 위치를 안다

바퀴가 몇 바퀴 굴렀는지로 위치를 계산하는데, 미끄러지면 틀린다. 몇십 초만
지나도 눈에 띄게 어긋난다. 그래서 자이로 센서를 함께 쓴다. 바퀴는 얼마나
갔는지를 잘 알고, 자이로는 얼마나 돌았는지를 잘 안다.

그리고 **출발점을 원점으로 하는 좌표계 하나를 끝까지 유지한다.** 센서
데이터를 매번 그 좌표계로 옮겨 적는다. 매번 자기 기준으로 좌표를 새로 잡으면
변환 오차가 쌓이고, 전에 본 장애물을 재활용할 수 없다.

시뮬레이터는 이 오차를 그대로 흉내 낸다. 차가 믿는 위치는 실제 위치와 서서히
벌어지고, 그 오차까지 견디는 것이 목표다.

---

## 5. 갇혔을 때

이 방식에는 구조적 한계가 하나 있다.

**ㄷ자 모양 막다른 골목에 들어가면 스스로 못 나온다.**

이유는 이렇다. 이 알고리즘은 항상 목적지 쪽으로 가는 짧은 길을 찾는다. 그런데
함정에서 나오려면 **먼저 목적지 반대 방향으로 한참 후퇴**해야 한다. 이
알고리즘은 그런 판단을 못 한다. 안쪽 벽 앞에서 왔다갔다만 한다.

그래서 비상용 방법을 따로 둔다. 2.6에서 만들어 둔 격자 지도를 쓴다.

> 최근 몇 초 동안 목적지와의 거리가 줄어들지 않았다 → 갇힌 것으로 본다

갇혔다고 판단되면 격자 위에서 칸을 하나씩 따라가는 방식으로 탈출로를 찾는다.
이 방법은 느리지만 **길이 있으면 반드시 찾는다.** 함정을 벗어나면 원래
방식으로 돌아온다.

**평소엔 빠른 방식, 위기엔 확실한 방식.** 이중 구조다.

---

## 6. 경로를 어떻게 따라가는가

### 6.1 경로는 명령이 아니라 안내선이다

찾아낸 경로에는 문제가 있다. 직선 구간에서 호 구간으로 넘어가는 순간, **핸들이
중립에서 꺾인 상태로 순간이동해야 한다.** 물리적으로 불가능하다.

그래서 경로를 정확히 밟으려 하지 않는다.

> 경로 위에서 **내 앞 1미터쯤 되는 지점**을 하나 찍는다. 그 지점을 향해 부드러운
> 곡선으로 간다. 차가 나아가면 그 지점도 앞으로 밀린다. 계속 쫓아간다.

말 앞에 당근을 매달아 놓은 것과 같다. 차가 항상 저 앞의 한 점만 보고 있어서
**경로의 각진 부분이 저절로 뭉개진다.**

대신 코너를 살짝 안쪽으로 잘라먹는다. 그만큼의 여유를 2.1에서 미리 넣어
두었다. 여기서 두 부분이 연결된다.

앞을 얼마나 멀리 볼지(`Ld`)는 두 가지로 정한다.

- 속도에 비례한다. 빠르면 멀리 보고, 느리면 가까이 본다.
- **코너가 급하면 줄인다.** 이게 없으면 급코너에서 크게 잘라먹는다.

### 6.2 속도

세 가지 중 가장 작은 값을 쓴다.

- 정해둔 최고 속도
- 앞이 트인 정도에 비례한 속도
- 코너가 급할수록 낮아지는 속도 (횡가속도 한계)

곡률은 **앞으로 4 m 구간의 최댓값**을 본다. 코너에 들어가서 줄이면 늦다.
미리 보고 지금부터 줄여야 한다.

여기에 조건이 하나 더 있다. **계획을 한 번 다시 짜는 사이에 차가 이동하는
거리가, 센서가 보는 거리보다 짧아야 한다.** 안 그러면 못 본 곳으로 뛰어드는
셈이다.

### 6.3 처음 방향이 크게 어긋났을 때

경로의 첫 구간이 지금 차가 향한 방향과 크게 어긋나 있으면 그냥 전진해서는 못
맞춘다. 제자리 회전이 안 되기 때문이다. 이때는 전진과 후진을 섞은 방향 전환
동작을 먼저 넣어야 한다.

---

## 7. 전체 흐름

세 개의 루프가 서로 다른 속도로 동시에 돈다.

### 계획 루프 (1초에 10번)

1. **본다** — 라이다로 점을 받고, 가까운 것끼리 묶는다 (4.1)
2. **이해한다** — 묶음마다 도형을 정한다. 충분히 보였으면 원, 아니면 볼록한
   조각들로 쪼갠다 (4.2, 2.4)
3. **기억한다** — 저번에 본 것과 짝지어 누적하고 지도에 옮긴다 (4.3)
4. **부풀린다** — 안전 여유만큼 키우고, 빈 공간을 삼키지 않는 선에서 합친다
   (2.1, 2.5)
5. **노선도를 만든다** — 접점을 전부 찾고, 회전 방향이 맞는 연결만 남긴다 (3.3)
6. **고른다** — 길이·여유·꺾임·미지 영역을 함께 따져 최선의 경로를 찾는다.
   충돌 검사는 A\*가 꺼낼 때 한다 (3.4, 3.5)
7. **고집을 부린다** — 확실히 낫지 않으면 가던 길을 유지한다 (3.6)

### 추종 루프 (1초에 50번)

경로 위 앞쪽 지점을 향해 핸들을 조절하고, 상황에 맞게 속도를 정한다. (6장)

### 안전 루프 (1초에 100번)

바로 앞에 뭔가 있으면 **무조건 멈춘다.** 계획이 무엇이든 상관없이 이 판단이
최우선이다.

단, 후진 중에는 전방 정지 조건을 걸지 않는다. 걸면 장애물에 코를 박은 채
영원히 못 빠져나온다.

---

## 8. 반드시 대비해야 할 상황

아래는 "혹시 일어나면"이 아니라 **반드시 일어나는** 일들이다.

**내가 안전선을 넘었다.**
실제 충돌은 아니고 안전 영역을 침범한 상태다. 계획을 멈추고 장애물 반대
방향으로 물러난다. 나가야 할 방향이 앞쪽이면 천천히 전진하고, 뒤쪽이면
후진한다. 차는 제자리에서 못 돌기 때문에 코를 박은 상태에서는 후진이 유일한
답이다. 후진하기 전에 **뒤가 비었는지도 확인해야 한다.**

**비상 정지가 걸린 채 멈춰 있다.**
비상 정지는 "멈추라"고만 할 뿐 빠져나오게 해주지는 않는다. 코가 막힌 채로
정지하면 **그대로 영구 동결된다.** 그래서 코가 막힌 채 속도가 0이면 탈출
모드로 넘겨야 한다. 이걸 빠뜨리면 차가 장애물 앞에서 영원히 서 있는다.

**같은 자리에서 탈출이 반복된다.**
짧게만 물러나면 곧장 같은 곳으로 밀고 들어가 한계 순환에 빠진다. 반복 횟수를
세어 후진 시간을 점점 늘린다.

**목적지가 장애물 안에 있다.**
도달할 수 없다. 목적지에서 가장 가까운 갈 수 있는 지점을 대신 목표로 삼고,
도착하면 여기까지가 한계라고 알린다.

**어떤 경로도 찾지 못했다.**
아직 안 가본 영역 중 목적지 방향에 가장 가까운 곳을 임시 목표로 잡고 간다.
가보면 새 정보가 생기고, 그러면 답이 나올 수 있다.

**계산이 제시간에 안 끝났다.**
가던 경로를 유지하고 속도를 줄인다. 다음 주기에 다시 시도한다.

---

## 9. 만드는 순서

이 순서를 지켜야 한다. 건너뛰면 나중에 문제가 생겼을 때 **원인이 어디인지 알
수 없게 된다.**

| 단계 | 내용 | 통과 기준 |
|---|---|---|
| 1 | 계산 함수 세 개 (3.2) | 무작위 수십만 건 무오류, 원 경계 근처 포함 |
| 2 | 오차 없는 세상에서 경로 그리기 | 장애물 50개, 경로가 뚫는 경우 0건 |
| 3 | 센서 오차·가림·노이즈 추가 | **여기서 대부분이 무너진다** |
| 4 | 차의 운동학 (회전 반경, 조향 속도) | 추종 오차가 여유 안에 들어옴 |
| 5 | 함정 시나리오 | 폴백으로 탈출 |

이 구현은 5단계까지 마쳤다.

---

## 10. 측정 결과

| 시나리오 | 내용 | 도착 | 충돌 | 소요 | 계획 평균 |
|---|---|---|---|---|---|
| pillars | 흩어진 기둥 8개 | O | 없음 | 34 s | 81 ms |
| walls | 벽 + 기둥 | O | 없음 | 41 s | 49 ms |
| narrow | 좁은 문과 넓은 문 | O | 없음 | 17 s | 45 ms |
| forest | 기둥 26개 밀집 | O | 없음 | 81 s | 183 ms |
| trap | ㄷ자 막다른 골목 | O | 없음 | 31 s | 148 ms |

전 시나리오 도착, 충돌 0건.

`narrow`에서는 좁은 문이 부풀림 때문에 하나로 합쳐져 "통과 불가"로 자동
판정되고 넓은 문으로 돌아간다. `trap`에서는 접선 그래프가 갇히고 격자 폴백이
꺼내준다. 설계한 대로 동작한다.

---

## 11. 남은 한계

정직하게 적어둔다.

- **밀집 환경에서 계획 시간이 목표(100 ms)를 넘는다.** `forest`에서 평균
  183 ms, 최악 430 ms다. 원 개수 상한과 계획 반경을 더 줄이거나, 그래프 구성을
  numpy로 벡터화해야 한다.
- **겹친 두 덩어리의 경계를 이어 도는 경로는 못 만든다.** 꼭짓점을 공유하는
  경우(2.4)는 자동으로 해결되지만, 서로 다른 물체가 겹친 경우에는 경계가
  교차하는 지점에 노드가 없다. 지금은 병합(2.5)과 격자 폴백(5장)이 이 경우를
  덮고 있다. 제대로 하려면 경계 교차점을 노드로 추가해야 한다.
- **동적 장애물을 다루지 않는다.** 추적기는 속도를 추정하지 않고, 계획도
  시간 축을 갖지 않는다.
- **위치 추정이 오도메트리뿐이다.** 오차가 단조 증가한다. 긴 주행에는 SLAM이
  필요하다.
- **후진 경로를 계획하지 않는다.** 후진은 탈출 상황의 반응 동작으로만 쓴다.
  좁은 곳에서 방향을 트는 기동이 필요하면 Reeds-Shepp 계열이 있어야 한다.
