StarCoder14/Auto_DRIVING/보고서_구상.md

# 연구보고서 구상 — 지도 없이 길을 찾는 자율주행 알고리즘

항목마다 **키워드**와 **담을 내용**을 달았다. 살은 직접 붙인다.
숫자는 README 에 남은 실측값이므로 그대로 인용해도 된다.

---

# I. 서론

## 1. 연구의 목적 및 필요성

### 가. 연구의 필요성

**키워드** — 사전 지도 의존, 미지 환경, 온라인 경로 계획, 소형 이동 로봇, 저비용 센서

기존 자율주행은 정밀 지도와 고가 센서에 기댄다. 그러나 재난 현장, 실내 배달,
농업용 로봇처럼 **지도를 미리 만들 수 없는 환경**이 존재한다.
이런 환경에서는 센서로 보이는 만큼만 알고 달리면서 계획을 계속 고쳐야 한다.
고등학생이 다룰 수 있는 예산과 부품으로 이 문제에 접근할 수 있는지 확인할 필요가 있다.

### 나. 연구의 목적

**키워드** — 지도 없는 경로 계획, 실시간성, 운동학적 실현 가능성, 시뮬레이션 검증, 실물 이식

사전 지도 없이 센서 정보만으로 목적지까지 가는 경로 계획 알고리즘을 설계하고,
시뮬레이션으로 성능을 정량 검증한 뒤 실제 차량에 이식하는 것을 목적으로 한다.
**계획 한 번을 0.1초 안에 끝내면서, 차가 실제로 그릴 수 있는 경로만 만드는 것**이 핵심 조건이다.

## 2. 연구 내용

서론에서는 **무엇을 만들 것인가**까지만 쓴다.
고친 과정과 그 결과는 본론에서 다룬다.

### 가. 프로토타입 알고리즘의 설계

**키워드** — 장애물 부풀리기, 점 근사, 접선과 원호, 가시성 그래프, A\* 탐색

첫 모델의 착상은 **차를 크기 없는 점으로 바꾸는 것**이다.
장애물을 차의 크기만큼 부풀리면, 차의 폭을 더 이상 따로 신경 쓰지 않아도 된다.

부풀린 원들 사이의 최단 경로는 고무줄을 당긴 모양, 즉 **접선 → 원호 → 접선**이 된다.
이 성질을 이용하면 무한히 많은 경로 후보를 유한 개로 줄일 수 있다.
접점들을 역으로, 접선과 원호를 노선으로 삼아 지하철 노선도와 같은 그래프를 만들고,
여기에 A\* 탐색을 적용하여 최단 경로를 구한다.

갈림길을 하나씩 모두 따라가면 장애물 n 개에 경로가 2의 n 제곱 개로 늘어나므로,
그래프 탐색으로 바꾸어 계산량을 줄이는 것이 이 설계의 핵심이다.

### 나. 알고리즘의 구현 방법 설계

**키워드** — 모듈 분리, 계층 구조, 주기 분리, 시뮬레이터, 동일 코드 공유

**1) 계층을 나눈다**
인식, 계획, 추종, 안전을 서로 다른 모듈로 나눈다.
한 모듈을 고칠 때 다른 모듈이 영향을 받지 않아야 원인을 짚을 수 있다.

**2) 주기를 나눈다**
세 가지 일은 필요한 빈도가 다르므로 각각 다른 주기로 돌린다.

| 계층 | 주기 | 하는 일 |
|---|---|---|
| 계획 | 초당 10회 | 센서로 지도를 갱신하고 경로를 다시 찾는다 |
| 추종 | 초당 50회 | 경로를 보고 속도와 조향을 정한다 |
| 안전 | 초당 100회 | 부딪힐 것 같으면 멈춘다 |

계획이 오래 걸려도 추종과 안전은 계속 돌아야 한다.
이 구조 덕분에 계획이 실패해도 차가 폭주하지 않는다.

**3) 시뮬레이터를 먼저 만든다**
실물은 한 번 시험하는 데 시간이 오래 걸리고 같은 조건을 반복할 수 없다.
따라서 세계, 차량, 센서를 수식으로 흉내 내는 시뮬레이터를 먼저 만들고,
**시뮬레이터와 실제 차량이 같은 계획 코드를 쓰도록** 설계한다.
알고리즘 입장에서 달라지는 것은 센서 값이 어디서 오고 명령이 어디로 가는지뿐이다.

### 다. 실물 이식에서 예상되는 문제

**키워드** — 계산 자원 한계, 센서 잡음, 위치 추정 오차, 통신 지연, 비상 정지

시뮬레이터에서 잘 도는 알고리즘이 실물에서 그대로 될 것이라고 보기 어렵다.
설계 단계에서 다음 문제를 미리 예상하고 대비 방안을 함께 마련한다.

**1) 계산 능력의 한계**
계획 한 번을 0.1초 안에 끝내야 하는데, 소형 보드는 노트북보다 느리다.
→ 탐색 확장 횟수에 상한을 두고, 시간 안에 못 찾으면 이전 경로를 유지한다.

**2) 센서의 한계**
시뮬레이터의 센서는 항상 정확한 값을 준다. 실제 센서는 잡음이 있고,
유리나 검은 표면을 놓치며, 볼 수 있는 방향도 좁다.
→ 값을 하나씩 믿지 않고 격자에 누적하여 확률로 다룬다.

**3) 위치 추정 오차**
시뮬레이터는 차의 위치를 정확히 안다. 실물은 스스로 추정해야 한다.
엔코더 없이 자이로와 명령 속도만으로 추정하면 오차가 계속 쌓인다.
→ 짧은 구간만 믿고, 계획을 자주 다시 하여 오차가 누적될 시간을 줄인다.

**4) 통신 지연과 끊김**
계산하는 장치와 모터를 움직이는 장치가 분리되어 있어 명령이 늦거나 끊길 수 있다.
→ 마이크로컨트롤러에 **감시 장치**를 두어, 명령이 일정 시간 오지 않으면 스스로 멈춘다.

**5) 차량 모형과 실제의 차이**
바퀴 미끄러짐, 변속기의 후진 지연, 조향 중심의 오차는 모형에 없다.
→ 실물에서 실측하여 상수를 보정하고, 안전 여유를 크게 잡고 시작한다.

## 3. 기대 효과 및 활용 방안

### 가. 기대 효과

**1) 저비용 센서로도 자율주행이 가능함을 검증**
360도 라이다 없이 전방 거리 센서만으로 목표 성능에 도달하는지 확인한다.

**2) 알고리즘 설계에서 가정 검증의 중요성 제시**
성능 향상의 대부분이 새 기법 도입이 아니라 **틀린 가정을 찾아내는 데서** 나왔음을 보인다.

**3) 측정 기준이 결론을 바꾼다는 사례 제시**
같은 주행을 뒷바퀴 축 기준으로 재면 무충돌, 차체 기준으로 재면 접촉으로 나온다.

### 나. 활용 방안

**1) 교육용 자율주행 실습 자료**
시뮬레이터와 실물이 같은 코드를 공유하므로 단계별 학습에 쓸 수 있다.

**2) 소형 실내 이동 로봇의 기초 자료**
지도 구축 장비 없이 동작하므로 저가 서비스 로봇에 응용할 수 있다.

**3) 알고리즘 성능 측정 방법론의 사례**
튜닝셋과 시험셋 분리, 통제 변인 고정 등 정량 비교 절차를 제시한다.

---

# II. 본론

## 1. 선행 연구 및 이론적 배경

### 가. 경로 계획 문제의 분류

**키워드** — 전역 계획, 지역 계획, 사전 지도 유무, 정적/동적 환경

지도를 아는 전역 계획과 센서에만 의존하는 지역 계획을 구분한다.
본 연구는 **지도 없이 전역 목적지를 향하는 문제**로, 둘 사이에 놓인다.

### 나. 비홀로노믹 제약과 최소 회전 반경

**키워드** — 비홀로노믹, 아커만 조향, 자전거 모형, 최소 회전 반경, 곡률

자동차는 옆으로 못 가고 제자리에서 못 돈다.
따라서 **두 점을 잇는 최단 경로가 직선이 아니다.**
이 제약을 계획 단계에서 반영하지 않으면 추종이 불가능한 경로가 나온다.

### 다. 설정 공간과 장애물 부풀리기

**키워드** — 설정 공간(configuration space), 민코프스키 합, 부풀리기, 점 근사

장애물을 차의 크기만큼 부풀리면 차를 크기 없는 점으로 취급할 수 있다.
복잡한 문제를 이미 풀린 문제로 바꾸는 표준적 방법이다.

### 라. 그래프 탐색 기반 경로 계획

**키워드** — 가시성 그래프, 접선, 원호, A\*, 휴리스틱, 허용 가능성(admissibility)

**1) 가시성 그래프와 접선**
원형 장애물 사이의 최단 경로는 고무줄을 당긴 모양, 즉 **접선 → 원호 → 접선**이다.
이 성질 덕분에 무한한 후보를 유한 개의 노드와 간선으로 바꿀 수 있다.

**2) A\* 탐색**
시작점부터의 실제 비용과 목적지까지의 추정 비용을 더해 가장 유망한 노드부터 펼친다.
추정값이 실제보다 크지 않아야(허용 가능) 최적해가 보장된다.

### 마. 격자 기반 경로 계획과 하이브리드 A\*

**키워드** — 점유 격자, 로그 오즈, 거리장, 상태 격자, 모션 프리미티브, 방향(heading)

격자 A\* 는 대각선으로만 꺾여서 차가 못 따라간다.
**하이브리드 A\* 는 상태에 방향을 넣고**, 차가 실제로 그릴 수 있는 곡선 조각만 이어 붙인다.

### 바. 경로 추종

**키워드** — 순수 추종(pure pursuit), 전방 주시 거리, 첨점(cusp), 예측 정지

경로는 명령이 아니라 안내선이다. 앞쪽 한 점을 보고 그쪽으로 핸들을 꺾는다.

## 2. 연구 방법

### 가. 시뮬레이터 설계

**1) 목적**
실물 제작 전에 알고리즘을 반복 측정하기 위한 환경을 만든다.
같은 조건을 수백 번 재현할 수 있어야 정량 비교가 가능하다.

**2) 구성**

**가) 세계 모형** — 원형 기둥과 선분 벽으로 이루어진 2차원 공간
**나) 차량 모형** — 자전거 모형, 조향각 제한, 가감속 제한, 바퀴 미끄러짐 없음 가정
**다) 센서 모형** — 거리 측정, 측정 잡음, 시야각 제한, 원뿔형 빔

**3) 변인 설정**

**가) 독립 변인**
알고리즘의 구성 요소. 한 번에 하나씩만 바꾼다.
(1) 경로 계획 방식 (접선 그래프 / 하이브리드 A\*)
(2) 후진 첫 구간 벌점의 크기 (12, 30, 60, 120)
(3) 여유 공간에 따른 감속 계수
(4) 센서 구성 (360도 라이다 / 전방 스캔 센서)

**나) 종속 변인**
(1) 목적지 도착 여부
(2) 주행 완료 시간(초)
(3) **차체와 장애물 사이 최소 거리**(m) — 음수이면 접촉
(4) 계획 1회 소요 시간(ms)
(5) 경로 교체 횟수

**다) 통제 변인**
(1) 지도(시나리오)와 출발점, 목적지
(2) 차량 제원 — 길이, 폭, 축거, 최대 조향각, 최대 속도
(3) 센서 사양과 잡음 크기
(4) 시뮬레이션 시간 간격
(5) **난수 시드** — 같은 시드는 언제나 같은 잡음과 같은 지도를 만든다

### 나. 알고리즘 개선 과정

**키워드** — 한 번에 하나씩, 문제 → 원인 → 해결, 버린 시도의 기록

개선은 다음 절차를 반복하였다.

**1) 문제를 숫자로 만든다**
"경로를 자주 바꾼다" 대신 **경로 교체 횟수**를,
"뒤로 간다" 대신 **차의 진행 방향과 경로 출발 방향이 100도 이상 벌어진 횟수**를 센다.
숫자로 만들지 못한 문제는 고쳤는지 확인할 수 없다.

**2) 원인을 짚는다**
증상이 아니라 원인을 고친다.
예를 들어 경로를 자주 바꾼 것은 문턱값이 낮아서가 아니라
두 비용을 **서로 다른 시점에서 쟀기** 때문이었다.

**3) 한 번에 하나만 바꾼다**
두 가지를 동시에 고치면 어느 쪽이 효과를 냈는지 알 수 없다.
실제로 두 개선을 함께 적용했을 때 서로 간섭하여 성능이 나빠진 사례가 있었다.

**4) 버린 시도도 기록한다**
실패한 시도는 그 방향이 막혀 있다는 정보이다.
회전 방향 잠금, 후진 금지, 급격한 교체 억제 장치는 측정 결과 나빠져서 되돌렸다.

**5) 고칠 수 있는 문제와 방법의 한계를 구분한다**
상수를 조정해서 해결되지 않고 표현 방식 자체에서 비롯된 문제는
개선이 아니라 **방법 교체**로 다룬다.

### 다. 실험군 및 대조군

**1) 대조군**
**가) 단계별 비교의 대조군** — 각 개선을 적용하기 **직전** 버전.
같은 지도, 같은 시드에서 고치기 전과 후를 나란히 잰다.
**나) 방법 비교의 대조군** — 완성된 접선 그래프 알고리즘.
제안 방법인 하이브리드 A\* 의 기준선 역할을 한다.

**2) 실험군**
각 개선을 적용한 버전, 그리고 최종 하이브리드 A\* 알고리즘.

### 라. 지도 구성 및 과적합 방지

**키워드** — 고정 시나리오, 무작위 생성, 튜닝셋, 시험셋, 과적합, 풀이 가능성 검사

**1) 고정 시나리오 다섯 개** — pillars, walls, narrow, trap, forest.
개선의 원인을 짚기 쉬우나, 계속 같은 지도만 쓰면 그 지도에 맞춰 조정하게 된다.

**2) 무작위 지도** — 공간 크기, 기둥 개수와 반지름, 출발 방향을 난수로 정한다.
풀 수 없는 지도는 자동으로 다시 뽑는다.

**3) 튜닝셋과 시험셋 분리** — 상수 조정에는 시드 0~39 만 쓰고,
성능 보고에는 **한 번도 보지 않은** 시드 1000~1039, 2000~2039 를 쓴다.

### 마. 충돌 판정 기준

**키워드** — 대표점 판정, 차체 사각형 판정, 판정 기준의 엄격성

**뒷바퀴 축 한 점**으로 판정하면 차체 앞부분이 장애물을 파고들어도 무충돌로 기록된다.
따라서 **차체 사각형 둘레 전체**와 실제 장애물 사이의 최소 거리로 다시 정의한다.

## 3. 연구 결과

### 가. 계산 속도 개선 (지연 평가 도입)

| 처리 | 계획 1회 소요 시간 | 검사한 노선 수 |
|---|---|---|
| 전수 사전 검사 | 2,253 ms | 5,709 |
| 지연 평가 | **24 ms** | 평균 25 |

경로 비용은 전수 검사와 소수점까지 일치하였다. 근사가 아니다.

### 나. 경로 교체 억제 (비교 시점 보정)

| 시나리오 | 보정 전 | 보정 후 |
|---|---|---|
| pillars 경로 교체 | 36회 | 14회 |
| narrow 경로 교체 | 70회 | 10회 |
| narrow 도착 | 25초 내 실패 | 13.1초 |

### 다. 후진 지시 제거 (벌점 도입)

| 시나리오 | 되돌아가기 횟수 | 주행 시간 |
|---|---|---|
| pillars | 7회 → 0회 | 18.4초 → 18.9초 |
| walls | 30회 → 0회 | 41.3초 → **18.0초** |
| trap | 7회 (골목 탈출에 필요) | 25.1초 → 23.0초 |

벌점 크기별 결과: 30 은 walls 도착 실패, 60 은 trap 47.3초로 지연, **120 에서 모두 해결**.

### 라. 두 알고리즘의 비교

| 시나리오 | 하이브리드 A\* 시간 | 차체 최소 여유 | 접선 그래프 시간 | 차체 최소 여유 |
|---|---|---|---|---|
| pillars | 18.5 s | 0.62 m | 25.0 s | 0.52 m |
| walls | 19.1 s | 0.44 m | 17.6 s | 0.65 m |
| narrow | 8.8 s | 0.30 m | 12.7 s | 0.70 m |
| trap | 20.9 s | 0.28 m | 34.2 s | 0.03 m |
| forest | 21.6 s | 0.29 m | 40.8 s | **-0.05 m (접촉)** |

통과 가능한 최소 틈: **1.69 m → 0.7 m**

### 마. 무작위 환경 성능 (시험셋)

한 번도 보지 않은 지도 40개에서 **40/40 도착, 접촉 0건, 차체 최소 여유 0.185 m**.

### 바. 실물 이식 결과

단일 보드 컴퓨터에서 계획 주기 **평균 16.0 ms, 최대 68.1 ms** (예산 100 ms).
마이크로컨트롤러와의 통신은 **50.0 Hz, 체크섬 오류 0건**,
명령이 끊기면 스스로 정지하는 감시 장치가 작동함을 확인하였다.

## 4. 연구 결과 분석

### 가. 지연 평가가 정확도를 잃지 않은 이유

**키워드** — 하한 비용, 허용 가능성, 필요한 것만 계산

A\* 가 꺼내는 순서는 비용 순이므로, 목적지에 도달한 시점에 아직 검사하지 않은 노선은
이미 더 비쌀 수밖에 없다. 따라서 **검사를 미루어도 최적성이 보존된다.**

### 나. 히스테리시스가 작동하지 않은 원인

**키워드** — 기준 시점 불일치, 값의 노후화

두 경로의 비용을 **서로 다른 시점에서** 쟀기 때문이다.
기존 경로 비용은 옛 위치에서, 새 경로 비용은 현재 위치에서 잰 값이었으므로
차가 전진할수록 기존 값만 낡아 커졌고, 새 경로가 언제나 싸 보였다.

### 다. 벌점 크기의 비선형성

**키워드** — 금지와 허용 사이, 어중간한 제약의 위험

금지(무한대 벌점)는 골목 탈출을 막고, 약한 벌점은 후진 지시를 막지 못한다.
**중간값이 가장 나빴다**는 점은, 제약의 세기가 단조롭게 작용하지 않음을 보여준다.

### 라. 방법 전환이 필요했던 이유

**키워드** — 매개변수 조정의 한계, 표현력의 한계

접선 그래프에서는 호가 곧 부풀린 경계이므로 **안전 여유와 회전 반경을 분리할 수 없다.**
이는 상수를 바꿔서 해결되는 문제가 아니라 표현 방식 자체의 한계이다.

### 마. 측정 기준이 결론에 미친 영향

**키워드** — 대표점의 함정, 판정 기준과 결론

뒷바퀴 축 기준으로는 "충돌 0건"이었으나, 차체 기준으로 재니 forest 에서 5 cm 침범,
trap 에서 3 cm 접근이 드러났다. **측정 방법이 틀리면 결론도 틀린다.**

### 바. 과한 안전장치의 역효과

여유가 작을 때 강하게 감속시키자 벽과 나란히 달릴 때마다 느려졌다.
감속을 약화하니 walls 가 24.7초에서 19.1초로 빨라졌고,
**차체 여유는 0.21 m 에서 0.44 m 로 오히려 증가**하였다.
예측 정지가 이미 안전을 담당하고 있었기 때문이다.

---

# III. 결론

## 1. 결론

**키워드** — 가정의 검증, 방법의 교체, 정량 비교

사전 지도 없이 저비용 센서만으로 목적지에 도달하는 경로 계획 알고리즘을 설계하였고,
한 번도 보지 않은 무작위 환경 40개에서 전부 도착, 접촉 0건을 확인하였다.
계산 시간은 실시간 요구의 6분의 1 수준이며, 실물 이식까지 완료하였다.

성능 향상의 대부분은 새로운 기법의 도입이 아니라
**매 단계에서 틀린 가정을 하나씩 찾아 버린 결과**였다.

## 2. 맺는 글 및 고찰

**키워드** — 남은 한계, 향후 과제

**남은 한계**
- walls 시나리오는 이전 알고리즘보다 여전히 느리다 (벽 끝 회전이 보수적)
- trap 에서 탐색이 간헐적으로 1.2~1.6초까지 소요된다 (이전 탐색을 재사용하지 못함)
- 바퀴 미끄러짐, 유리·검은 표면에서의 센서 실패는 시뮬레이터가 재현하지 못한다

**향후 과제**
- 이전 탐색 결과를 재사용하는 점진적 탐색 도입
- 실제 주행 데이터로 차량 모형의 매개변수 보정
- 움직이는 장애물 대응

---

# IV. 참고문헌

**인용해야 할 것**
- Hart, Nilsson, Raphael, A Formal Basis for the Heuristic Determination of Minimum Cost Paths, 1968 — A\*
- Dolgov, Thrun, Montemerlo, Diebel, Practical Search Techniques in Path Planning for Autonomous Driving, 2008 — 하이브리드 A\*
- Coulter, Implementation of the Pure Pursuit Path Tracking Algorithm, 1992 — 순수 추종
- Reeds, Shepp, Optimal Paths for a Car That Goes Both Forwards and Backwards, 1990 — 후진 포함 경로
- Elfes, Using Occupancy Grids for Mobile Robot Perception and Navigation, 1989 — 점유 격자
- LaValle, Planning Algorithms, 2006 — 설정 공간, 비홀로노믹 계획 (교과서)

정확한 서지 정보는 직접 확인하고 쓸 것.
