StarCoder14/Auto_DRIVING/알고리즘_정리.md

# 지도 없이 길을 찾는 자율주행 알고리즘 요약

## 한 문장

차량은 전체 지도를 미리 만들지 않고, 센서에 보이는 장애물만 안전하게 부풀려 기억한 뒤, 보이는 범위 안에서 갈 수 있는 경로를 계산하고 조금 이동한 다음 다시 계획한다.

## 1. 세계 표현

차량의 폭, 센서 오차, 주행 오차를 합친 값을 안전 여유로 둔다. 장애물을 이만큼 부풀리면 차량은 크기 없는 점으로 계산할 수 있다. 단, 실제 차량이 따라갈 수 있도록 부풀린 반지름은 최소 회전 반경보다 작지 않게 한다.

장애물은 같은 크기의 원 여러 개를 이어 붙인 덩어리로 표현한다. 점 하나는 원 하나가 되고, 긴 벽은 여러 원으로 길고 가늘게 표현된다. 센서가 보지 못한 뒷면은 추측하지 않고 미지 영역으로 남긴다.

## 2. 경로 계산

장애물을 피하는 최단 경로는 직선과 장애물 표면의 곡선이 이어진 형태가 된다. 따라서 출발점, 목적지, 각 원의 접점 후보를 노드로 만들고, 충돌하지 않는 직선 연결을 그래프의 간선으로 만든다. 원 주변 구간도 다른 장애물과 겹치는지 검사한다.

그 그래프에서 A*를 실행한다. 경로 비용은 다음을 합친다.

- 이동 거리
- 장애물에 가까울수록 커지는 여유 벌점
- 방향을 많이 바꿀수록 커지는 꺾임 벌점
- 아직 관측하지 않은 영역을 지날 때의 작은 벌점

새 경로가 현재 경로보다 충분히 좋아졌을 때만 교체한다. 현재 경로가 막혔으면 즉시 교체한다.

## 3. 센서와 기억

센서 점은 거리에 따라 간격이 달라지므로 가까운 점 묶기 기준도 거리에 비례해 키운다. 연속 프레임에서 같은 장애물을 매칭해 위치를 평균내면 센서 노이즈로 인한 경로 떨림을 줄일 수 있다. 시야 안에서 여러 번 사라진 물체는 지우지만, 시야 밖으로 나간 물체는 사라졌다고 단정하지 않는다.

## 4. 경로 추종

계산된 경로의 꼭짓점을 그대로 밟으면 직선에서 곡선으로 넘어갈 때 조향이 순간적으로 바뀐다. 그래서 차량 앞쪽의 일정 거리만큼 떨어진 경로 지점을 목표로 삼아 부드럽게 따라간다. 속도가 빠를수록 목표점을 멀리 둔다.

속도는 최고 속도, 센서가 확인한 여유, 코너의 급함 중 가장 제한적인 값으로 정한다. 센서가 보는 거리보다 한 번의 계획 주기 동안 더 멀리 가지 않도록 제한한다.

## 5. 예외 처리

- 차량이 부풀린 장애물 안에 들어가면 계획을 멈추고 장애물 반대 방향으로 천천히 후진한다.
- 목적지가 장애물 안이면 장애물 바깥의 가장 가까운 접근 지점을 임시 목표로 삼는다.
- 경로가 없으면 목적지 방향의 미지 영역으로 짧게 이동해 새 정보를 얻는다.
- 계산이 늦으면 기존 경로를 유지하되 감속한다.
- 일정 시간 목적지와의 거리가 줄지 않으면 격자 기반 탈출 모드로 전환한다.

## 6. 시뮬레이터에서 확인하는 것

이 프로젝트는 실제 장비 없이 핵심 원리를 시각화한다. 주황색은 실제 장애물, 붉은색은 부풀린 안전 경계, 노란색 점선은 현재 경로, 파란색 차량은 앞쪽 목표점을 따라 움직이는 차량이다. 차량이 이동하면서 센서 범위 안으로 들어온 장애물만 플래너에 추가되고, 경로가 새로 계산된다.

이 코드는 교육용 시뮬레이션이다. 실제 주행에는 검증된 센서 드라이버, 위치 추정, 차량 동역학, 비상 정지, 하드웨어 안전 시험이 추가로 필요하다.
