StarCoder14/Auto_DRIVING/recordings/circle_model/close_pair.png

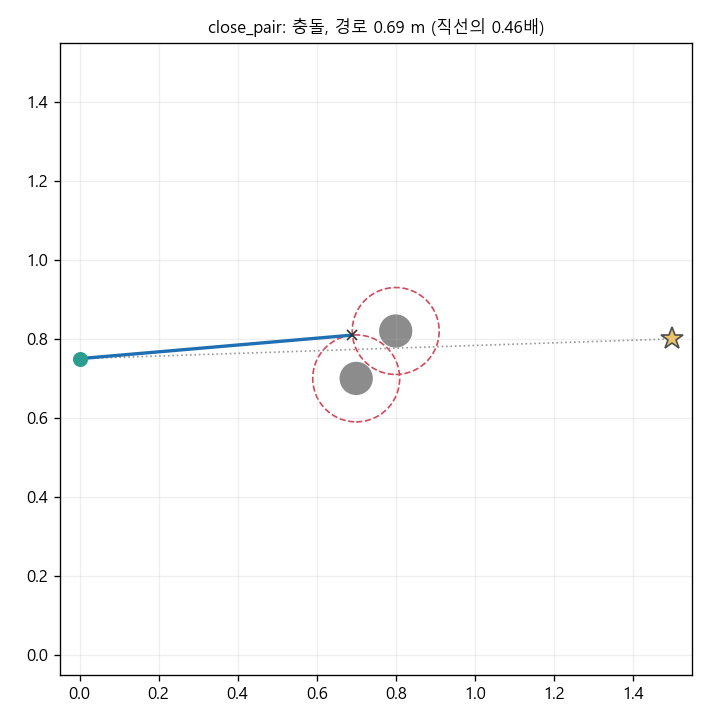
recordings/circle_model/close_pair.png
