StarCoder14/Auto_DRIVING/recordings/circle_model/cup.png

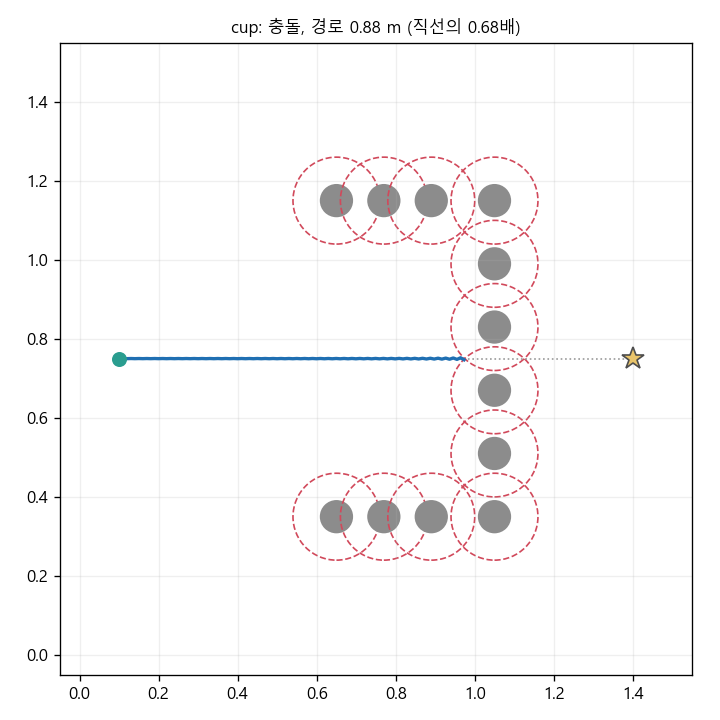
recordings/circle_model/cup.png
