StarCoder14/Auto_DRIVING/recordings/circle_model/goal_inside.png

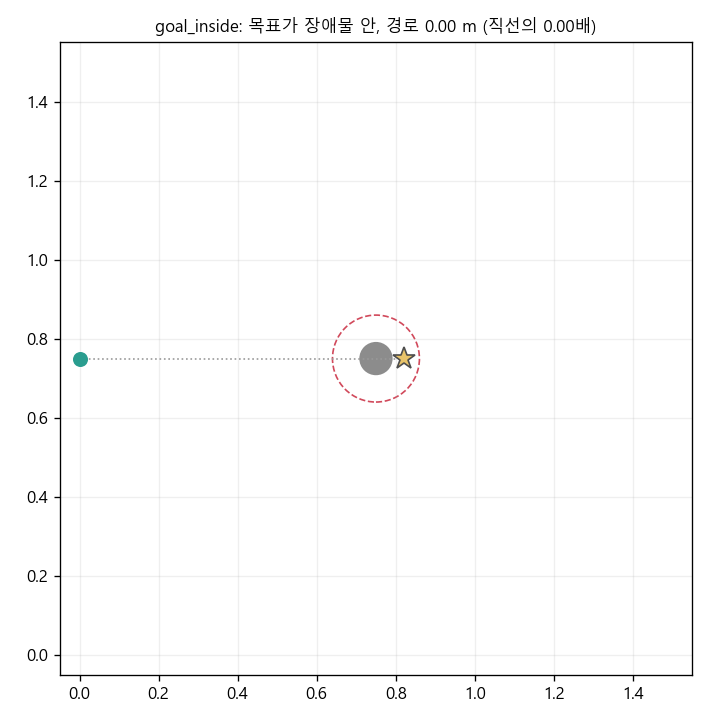
recordings/circle_model/goal_inside.png
