StarCoder14/Auto_DRIVING/recordings/circle_model/scattered.png

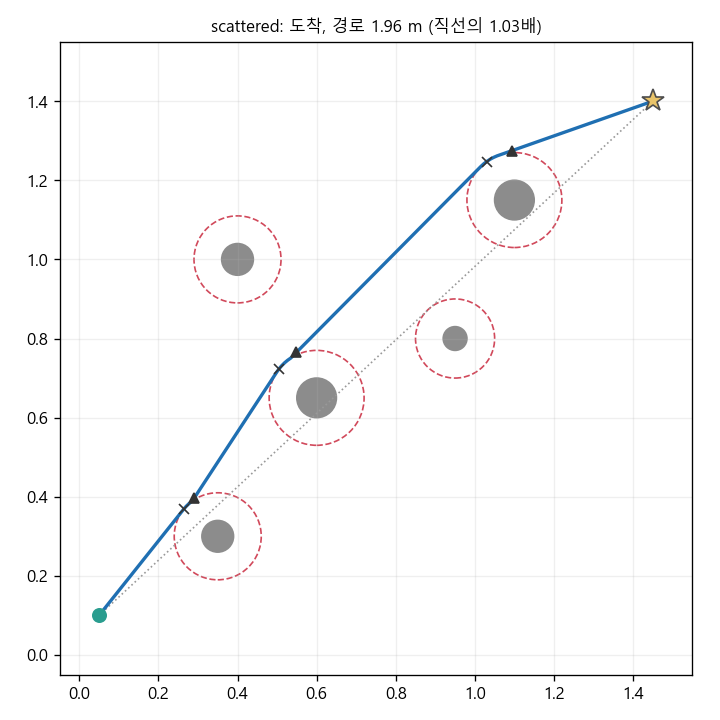
recordings/circle_model/scattered.png
