StarCoder14/Auto_DRIVING/recordings/circle_model/tie.png

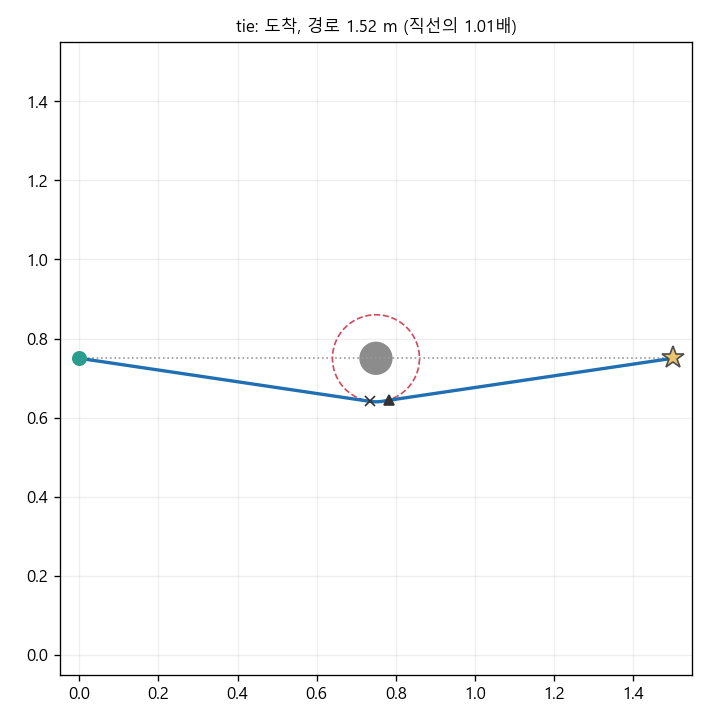
recordings/circle_model/tie.png
