StarCoder14/Auto_DRIVING/recordings/circle_model/wall.png

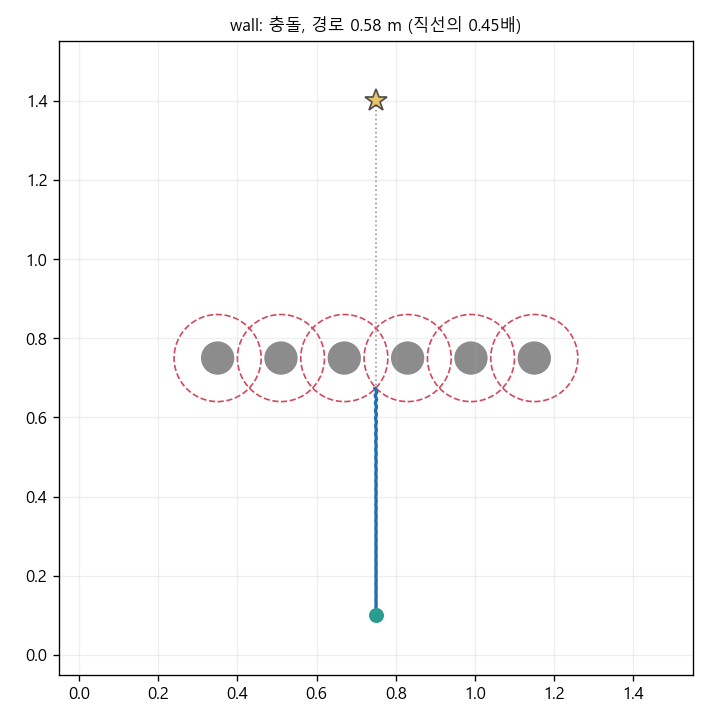
recordings/circle_model/wall.png
