StarCoder14/Auto_DRIVING/recordings/error_split/random0.png

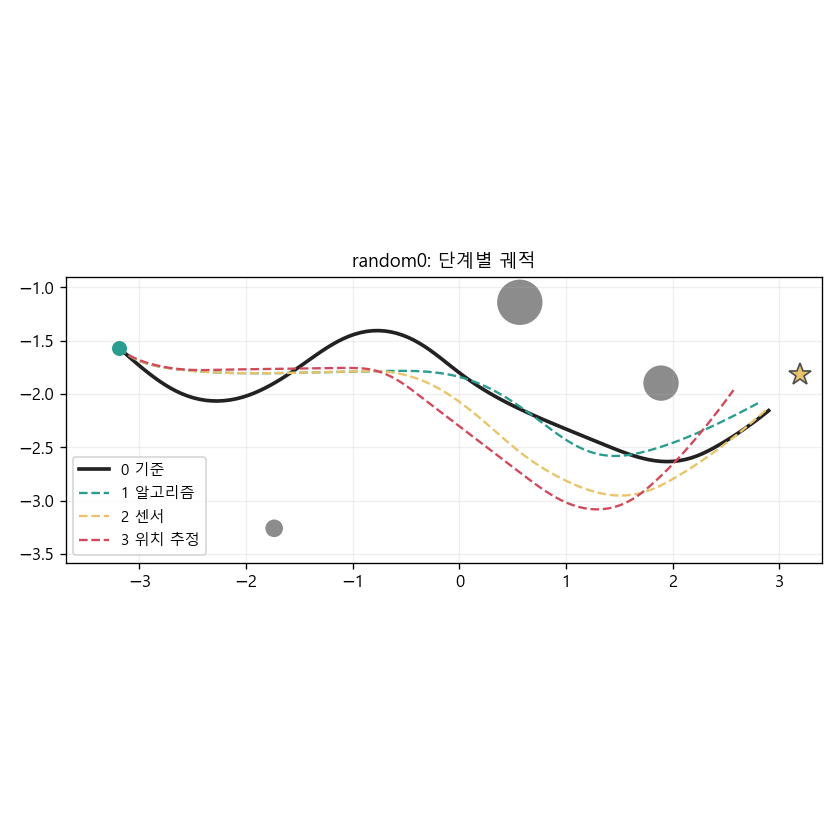
recordings/error_split/random0.png
