StarCoder14/Auto_DRIVING/recordings/error_split/random1.png

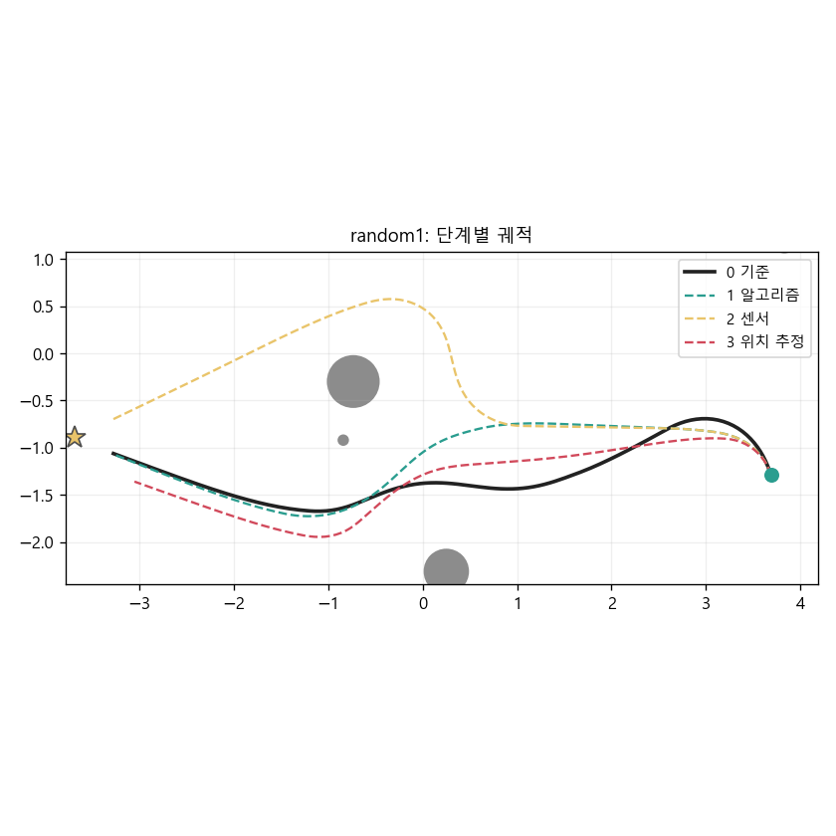
recordings/error_split/random1.png
