StarCoder14/Auto_DRIVING/report_pdf/template_p0.jpeg

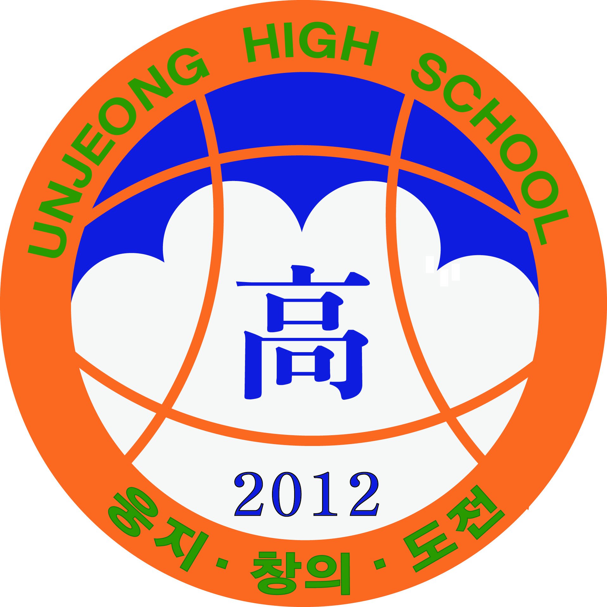
report_pdf/template_p0.jpeg
