StarCoder14/Auto_DRIVING/firmware/rccar_arduino/rccar_arduino.ino

/*
  rccar_arduino.ino -- RC카 아래쪽 담당 (아두이노 우노/나노)

  이 보드가 하는 일
    1. 서보 위에 올린 앞 거리 센서(샤프 적외선)로 좌우를 훑는다. 뒤 센서는 없다.
    2. 자이로(MPU6050)의 z 축 각속도를 읽는다. (지금은 USE_GYRO = 0 으로 꺼 둠)
    3. 오렌지파이가 보낸 속도와 조향을 서보와 변속기에 넘긴다.
    4. 명령이 끊기면 스스로 차를 세운다.   <- 이것이 이 보드의 가장 중요한 일

  이 보드가 하지 않는 일
    경로 계획, 지도 만들기. 그건 전부 오렌지파이가 한다.

  통신 형식은 rccar/link.py 머리말에 적혀 있다. 글자로 주고받아서 시리얼 모니터로 볼 수 있다.

  배선 (핀 번호는 아래 상수에서 바꾼다)
    I2C : SDA A4, SCL A5   (자이로 MPU6050)
    앞 거리 센서  A0       샤프 적외선 GP2Y0A21 의 신호선 (아날로그)
    센서 서보     D9      앞 거리 센서를 좌우로 돌린다
    조향 서보     D10
    DC 모터 2개, 드라이버 L9110S : B-1A D4, B-1B D5, A-1A D6, A-1B D7
                                 (VCC 는 모터 배터리, GND 공통)
    적외선 리모컨 수신기 D2   OUT 선. VCC 5V, GND
    RC 수신기     D2      사람이 조종기로 뺏을 때 (선택)

  센서 서보 고를 때
    속도가 0.1 초/60 도 이하인 것을 쓸 것. 시뮬레이션에서 150 도/초짜리 느린 서보는
    20 판 중 11 판에서 기둥에 박았다. 잴 때 각도가 평균 34 도 어긋나기 때문이다.

  필요한 라이브러리 (아두이노 IDE 라이브러리 매니저에서 설치)
    Servo          (기본 제공)
    Wire           (기본 제공)
    (샤프 거리 센서는 아날로그라 라이브러리가 필요 없다)

  안전 규칙
    - 최고 속도를 소프트웨어로 제한한다. 실제 RC카는 훨씬 빠르다.
    - 명령이 WATCHDOG_MS 동안 안 오면 무조건 멈춘다.
    - RC 조종기 채널이 올라오면 사람 조종이 우선이다.
*/

#include <Wire.h>
#include <Servo.h>
#include <IRremote.hpp>                // arduino-cli lib install IRremote (4.x)

// ---- 적외선 리모컨 (Car mp3 21키 리모컨, NEC)
//   숫자: 갈 거리(cm) 입력.  ▶|| (0x43): 출발.  EQ (0x09): 숫자 지우기.  달리는 중 아무 버튼: 정지.
//   켜면 멈춘 상태(irPaused). 멈춘 동안은 '사람 조종' 플래그(4)를 올려 파이가 기다리게 한다.
//   출발할 때 숫자가 있으면 G,<cm> 줄을 파이에 보낸다. 파이는 그 순간 차가 보는 방향으로 그 거리를 목적지로 잡는다.
const uint8_t PIN_IR = 2;
bool irPaused = true;
bool irHasGoal = false;
int irNum = 0;
const uint8_t IR_DIGITS[10] = {0x16,0x0C,0x18,0x5E,0x08,0x1C,0x5A,0x42,0x52,0x4A};   // 0~9
// 리모컨을 쓸지. 지금은 0 (꺼 둠). 샤프 센서 전원 잡음 때문에 수신기가 초당 수십 번 가짜 신호를 듣고,
// 그중 가끔 섞이는 '버튼처럼 보이는 신호'가 '달리는 중 아무 버튼 = 정지' 에 걸려 차를 멋대로 세웠음
// (2026-10-28 모터 시험이 0.1 초 만에 멈춤). 콘덴서로 잡음을 잡은 뒤 1 로 켤 것. 리모컨 코드는 그대로 둠
const uint8_t USE_IR = 0;

// ---- 손으로 출발과 정지 (리모컨 대신, 2026-10-28)
//   기다리는 중: 센서 정면 10~15 cm 에 손을 2 초 대면 '삐' -> 손을 치우면 1 초마다 '삑' 세 번 -> 출발.
//   달리는 중: 정면 10~15 cm 에 손(또는 장애물)이 1 초쯤 있으면 '삐이' 하고 멈춤.
//   목적지는 그 순간 차가 보는 방향으로 HAND_GOAL_CM. 출발할 때 G 줄을 보내는 것은 리모컨과 같음
// 달리는 중 정지에 쓰는 폭. 샤프는 10 cm 보다 가까우면 값이 뒤집혀 못 믿고,
// 15 cm 보다 멀면 길가의 기둥을 손으로 착각해 멋대로 설 수 있어서 이 폭으로 정함
const int HAND_MIN_MM = 100;
const int HAND_MAX_MM = 150;
// 기다리는 중 출발에 쓰는 기준. 거리로 바꾸기 전 전압값(ADC)이 이보다 크면 손으로 봄.
// 20 cm 에서 276 이었음(교정값). 10 cm 보다 가까우면 전압이 다시 내려가지만 276 보다는 높아서,
// 센서에 바짝 붙이지만 않으면 20 cm 안 어디든 됨. 10~15 cm 만 받았더니 손을 맞추기 너무 어려웠음
const int HAND_ADC_MIN = 276;
// 손 판정 사이에 이만큼 짧게 끊긴 건 무시함. 정면을 0.1 초마다 재니 한 번 튄 값에 처음부터 다시 세지 않게
const unsigned long HAND_GAP_MS = 300;
const unsigned long HAND_START_MS = 2000;
// 센서가 정면(0 도)을 약 1 초에 한 번 지나므로, 0.8 초면 정면에서 두 번 연달아 봤다는 뜻
const unsigned long HAND_STOP_MS = 800;
const int HAND_GOAL_CM = 100;
const uint8_t COUNTDOWN_BEEPS = 3;

enum HandState { HAND_WAIT, HAND_ARMED, HAND_COUNTDOWN };
HandState handState = HAND_WAIT;
unsigned long handSince = 0;      // 정면에서 손을 처음 본 때. 0 이면 지금 손 없음
unsigned long handLastAt = 0;     // 정면에서 손을 마지막으로 본 때
// 손으로 세운 뒤에는 손을 한 번 치워야 다시 셈. 세우려고 댄 손을 2 초 더 두면 다시 출발하는 일을 막음
bool handMustLeave = false;
unsigned long countdownAt = 0;
uint8_t countdownBeeps = 0;
unsigned long beepOffAt = 0;      // 0 이 아니면 이 시각에 부저를 끔 (delay 없이 울리려고)
// 카운트다운 3 초 동안 자이로 값을 모아 출발 직전에 기준점을 다시 잡음.
// 이때는 손을 치웠고 모터도 꺼져 있어 차가 확실히 가만히 있음
long biasSum = 0;
unsigned int biasCount = 0;
unsigned int biasFailStart = 0;   // 카운트다운 시작 때의 끊긴 횟수. 끝날 때와 다르면 모은 값을 안 씀

// ---------------------------------------------------------------- 설정
// 앞 거리 센서는 샤프 적외선 GP2Y0A21YK0F (아날로그, 10~80 cm). 신호선을 A0 에 꽂는다.
// 전에는 레이저 ToF(VL53L1X)였는데, 이 차는 계획서대로 샤프를 쓴다 (2026-10-21).
const uint8_t PIN_SHARP_FRONT = A0;
const uint8_t PIN_SWEEP_SERVO = 9;
const uint8_t PIN_STEER_SERVO = 10;
// 구동 모터는 DC 모터 2개 + L9110S 드라이버 (A, B 채널). 두 모터는 늘 같은 명령을 받는다.
// L9110: 두 입력의 차이로 돈다. 둘 다 LOW 면 정지. 입력이 떠 있으면 HIGH 로 읽혀 모터가 돈다
//   (2026-10-26 실제로 겪음: 모터 2개 배선인데 펌웨어가 D5 D6 만 써서 D4 D7 이 떠 바퀴가 계속 돌았다).
// A 채널: A-1A D6 (세기), A-1B D7. B 채널: B-1B D5 (세기), B-1A D4. 아래 출력부에서 A 와 같이 쓴다.
// D4 D7 은 PWM 이 안 되는 핀이라 후진(세기 핀 반대편)은 제대로 안 된다. 뒤 센서가 없어 후진을 꺼 두었으므로 지금은 문제없다.
const uint8_t PIN_MOTOR_A1A = 6;      // 드라이버 A-1A (PWM 핀)
const uint8_t PIN_MOTOR_A1B = 7;      // 드라이버 A-1B (보통 핀)
const uint8_t PIN_RC          = 2;      // 쓰지 않으면 USE_RC 를 0 으로
const uint8_t PIN_BUZZER      = 13;     // 이 차의 부저는 D13 (나노의 L LED 와 같은 핀)

// 능동형 부저 가정: 핀을 HIGH 로 두면 알아서 삑 운다. HIGH 만으로 소리가 안 나면
// 수동형이므로 beepOn() 을 tone(PIN_BUZZER, 2000) 으로 바꿀 것 (아래 함수 한 곳만 고치면 됨)
const uint8_t USE_BUZZER = 1;

const uint8_t USE_RC = 0;
const uint8_t USE_REAR_TOF = 0;        // 뒤 거리 센서 없음

// 샤프 적외선은 거리를 전압으로 준다. 1/거리 가 ADC 값에 선형이라, 거리(mm) = K / (adc - B).
// 이 두 상수는 2026-10-21 교정값이다 (계획서 6-다-4). firmware/sharp_calib 로 재서 정했다.
// 측정: 20cm->276, 30cm->187, 40cm->146, 50cm->113, 60cm->93 (ADC). 20~50cm 오차 몇 mm.
// 센서를 바꾸거나 전원 전압이 달라지면 다시 교정할 것.
const float SHARP_K = 54428.0;
const float SHARP_B = 5.16;
const int   SHARP_MIN_MM = 100;        // 이보다 가까우면 값이 뒤집혀 믿을 수 없다 (10 cm)
const int   SHARP_MAX_MM = 800;        // 이보다 멀면 '없음'으로 본다 (80 cm)
const uint8_t SHARP_SAMPLES = 5;       // 아날로그 잡음이 커서 여러 번 읽어 중앙값을 쓴다

const unsigned long WATCHDOG_MS = 300;  // 명령이 이 시간 안 오면 정지
// 모터 힘 255(끝까지)일 때 바닥에서 실제로 나는 속도. 2026-10-28 1 초씩 재 보니 57% 5 cm, 79% 7 cm, 100% 10 cm.
// 예전엔 1400(1.4 m/s)으로 가정해서 오렌지파이가 96 cm 갔다고 믿을 때 실제로 3 cm 갔음.
// 모터 드라이버 전원이 아두이노 5V(USB 전기)라 힘이 약함. 배터리로 옮기면 다시 잴 것. car_specs.py 와 같게
const int   MAX_SPEED_MMS = 100;
// 뒤를 못 보면 후진 명령은 받아도 0 으로 자름. 오렌지파이 쪽도 후진을 안 보내지만 한 겹 더 막음
const int   MAX_REV_MMS   = USE_REAR_TOF ? 450 : 0;
const float MAX_STEER_DEG = 32.0;       // 명령의 최대 조향각. 서보는 STEER_GAIN 배라 실제로는 48 도

// 조향 서보 보정: 바퀴가 정면일 때의 서보 각도와, 1 도 꺾을 때 서보가 움직이는 양
const float STEER_CENTER_DEG = 90.0;
// 오렌지파이는 최대 32 도로 알고 있어 그 이상은 안 보냄. 1.5 배로 돌려 32 도 명령에 서보가 48 도 돌게 함 (2026-10-28).
// 32 도로는 기둥을 피할 만큼 안 꺾였음. 오렌지파이 코드를 옮길 수 없어 펌웨어에서 늘림
const float STEER_GAIN       = 1.5;
// 방향 뒤집기. 차 뒤에서 앞을 볼 때 '왼쪽' 명령에 앞바퀴가 오른쪽으로 꺾이면 -1 로.
// 2026-10-28 바닥 주행 기록에서 오른쪽 24~32 도를 보낼 때마다 자이로가 왼쪽으로 도는 걸 재서 -1 로 정함.
// 이게 1 일 땐 방향을 바로잡으려 할수록 더 틀어져 차가 빙글빙글 감겨 들어갔음
const int STEER_DIR = -1;
// '전진' 명령에 두 바퀴가 다 뒤로 돌면 -1 로. 한쪽만 반대면 코드가 아니라 그 모터 선 두 가닥을 바꿔 꽂을 것
const int DRIVE_DIR = 1;

// 위 세 점을 이으면 힘 35(14%)쯤부터 움직이기 시작해 그 위로 힘에 비례해 빨라짐.
// 그래서 속도를 힘으로 바꿀 때 0 이 아니라 여기서부터 계산함
const int MOTOR_START_PWM = 35;
// DC 모터는 아주 느린 속도에서 안 돌고 소리만 난다. 이 PWM(0~255) 아래로는 0 으로 본다.
// 바닥에서 36%(91)는 거의 안 움직여서 47%(120)로 올림 (예전 60 은 바퀴 띄운 기준)
const int MOTOR_MIN_PWM = 120;

// 앞 센서가 훑는 각도 (도). 시뮬레이터의 tof_sweep 과 같은 범위
// 90 도까지 돌리면 센서가 오렌지파이 보드에 살짝씩 닿아서 75 도로 줄임 (2026-10-28). car_specs.FRONT_SENSOR 와 같게
const int SWEEP_MIN_DEG = -75;
const int SWEEP_MAX_DEG =  75;
const int SWEEP_STEP_DEG = 15;
// 서보가 멈추길 기다리는 시간.
// 45 ms 로 두면 15 도 옮기는 동안 다 못 가서, 잴 때 평균 6.7 도 어긋난다.
// 90 ms 면 1.2 도로 줄고, 무작위 지도 20 개에서 차체 여유가 0.068 m -> 0.109 m 로 넓어졌다.
// 대가는 주행 시간 0.4 초다. 서보가 느리면 이 값을 더 키워야 한다.
const unsigned long SWEEP_SETTLE_MS = 90;

// 센서 서보 보정: 차 정면을 볼 때의 서보 각도
const float SWEEP_CENTER_DEG = 90.0;
// 서보가 좌우로 똑같이 안 돎. 같은 75 도를 시켜도 왼쪽(차 뒤에서 앞을 볼 때)이 훨씬 더 가서 보드에 닿았음 (2026-10-28 영상).
// 시킨 각도에 이 값을 곱해서 서보에 줌. 파이에 보고하는 각도는 곱하기 전 값이라 지도 방향은 그대로임.
// 아직 좌우가 다르면 많이 가는 쪽 값만 0.05 씩 바꿔 다시 올릴 것
const float SWEEP_GAIN_LEFT  = 0.8;
const float SWEEP_GAIN_RIGHT = 1.0;
// 이 차의 센서 서보는 각도를 키우면 오른쪽으로 돎. 코드는 왼쪽을 양수로 쓰므로 서보에 줄 때만 뒤집음.
// 이게 없을 땐 왼쪽 기둥이 지도 오른쪽에 찍혀 지도가 거울처럼 뒤집혀 있었음 (2026-10-28, 보정 0.8 을 걸었더니 오른쪽이 줄어서 알게 됨)
const int SWEEP_SERVO_DIR = -1;

// ---------------------------------------------------------------- 상태
Servo sweepServo, steerServo;

int   sweepDeg = 0;
int   sweepDir = SWEEP_STEP_DEG;
// frontMM 을 잰 방향. 재자마자 서보를 다음 방향으로 돌리므로 sweepDeg 와 따로 둬야 함.
// 예전엔 sweepDeg 를 보내서 거리가 15 도 옆 방향에 찍혔음. 999 는 '아직 한 번도 안 잼' 표시 (link.py 와 같음)
int   measuredDeg = 999;
unsigned long sweepMovedAt = 0;
bool  sweepSettled = false;

int   cmdSpeedMMS = 0;
float cmdSteerDeg = 0.0;
unsigned long lastCmdAt = 0;

int   frontMM = -1, rearMM = -1;
int   frontAdc = 0;                  // 거리로 바꾸기 전 전압값. 손 출발 판정에 씀
float gyroDps = 0.0;
float gyroBias = 0.0;
// 자이로가 대답을 안 하기 시작한 때. 0 이면 지금 멀쩡함. 이 상태가 GYRO_BAD_MS 넘게 이어질 때만 '자이로 이상'(16)을 보냄.
// 예전엔 한 번만 끊겨도 리셋할 때까지 이상 표시를 붙여서, 달리다 진동에 순간 끊기면 매번 그 자리에 서 버렸음 (2026-10-28)
unsigned long gyroBadSince = 0;
const unsigned long GYRO_BAD_MS = 200;
// 지금까지 끊긴 횟수. 카운트다운 동안 끊겼는지 볼 때 씀
unsigned int gyroFailCount = 0;
unsigned long gyroCheckAt = 0;
const unsigned long GYRO_CHECK_MS = 500;

char  rxBuf[48];
uint8_t rxLen = 0;

unsigned long lastSendAt = 0;
const unsigned long SEND_PERIOD_MS = 20;   // 50 Hz

// ---------------------------------------------------------------- 자이로
const uint8_t MPU = 0x68;
// 자이로 범위를 ±500 도/초로 직접 정하고, 그 범위의 눈금(1 도/초당 65.5)으로 나눔.
// 예전엔 잠자기만 풀어서 자이로가 기본 범위(±250, 눈금 131)로 일하는데 펌웨어는 ±2000 눈금(16.4)으로 나눠서
// 도는 양이 8 배로 계산됐음 (2026-10-28 손으로 90 도 돌렸더니 663 도로 찍힘). ±250 은 부딪혀 확 돌 때 넘칠 수 있어 한 단계 넓힘
const uint8_t GYRO_RANGE_500 = 0x08;      // GYRO_CONFIG(0x1B) 의 FS_SEL=1
const float   GYRO_LSB_PER_DPS = 65.5;
// 이 차의 자이로 판은 뒤집혀 달려 있어서, 위에서 봐 시계 반대로 돌렸는데 - 가 나왔음. 코드는 왼쪽(시계 반대)이 +
const int     GYRO_DIR = -1;
// 자이로를 쓸지. 지금은 0 (꺼 둠). 2026-10-28 자이로 판을 꽂으면 I2C 선이 바닥에 붙어 주소 1~126 이 전부 시간 초과,
// 빼면 멀쩡했음. 판이 고장난 것으로 봄. 0 이면 자이로를 아예 안 부르고 0 도/초를 보냄.
// 방향은 오렌지파이가 조향각과 간 거리로 계산함 (rccar/car_specs.py 의 USE_GYRO 와 같은 값이어야 함). 새 판을 달면 1 로
const uint8_t USE_GYRO = 0;
// 축거 (m). 자이로가 꺼져 있을 때 도는 빠르기를 계산하는 데 씀. car_specs.py 의 wheelbase_cm 과 같게
const float WHEELBASE_M = 0.15;

void mpuWrite(uint8_t reg, uint8_t value) {
  Wire.beginTransmission(MPU);
  Wire.write(reg); Wire.write(value);
  Wire.endTransmission(true);
}

// 레지스터 하나를 읽음. 대답이 없으면 -1
int mpuRead(uint8_t reg) {
  Wire.beginTransmission(MPU);
  Wire.write(reg);
  Wire.endTransmission(false);
  Wire.requestFrom((uint8_t)MPU, (uint8_t)1, (uint8_t)true);
  if (Wire.getWireTimeoutFlag() || Wire.available() < 1) {
    Wire.clearWireTimeoutFlag();
    return -1;
  }
  return Wire.read();
}

// 잠자기 해제와 범위 설정. 전기가 흔들려 자이로가 혼자 다시 켜지면 잠자기, 기본 범위(±250)로 돌아가서 다시 넣어야 함
void mpuSetup() {
  mpuWrite(0x6B, 0);
  mpuWrite(0x1B, GYRO_RANGE_500);
}

// 0.5 초마다 설정이 그대로인지 봄. 혼자 다시 켜져 있으면 값이 엉뚱해도 끊김으로는 안 잡혀서 따로 확인함
void mpuCheck(unsigned long now) {
  if (!USE_GYRO) return;
  if (now - gyroCheckAt < GYRO_CHECK_MS) return;
  gyroCheckAt = now;
  int power = mpuRead(0x6B);
  int range = mpuRead(0x1B);
  if (power < 0 || range < 0 || (power & 0x40) || (range & 0x18) != GYRO_RANGE_500) mpuSetup();
}

void mpuBegin() {
  if (!USE_GYRO) return;
  mpuSetup();
  // 전원이 막 들어온 자이로는 값이 아직 안정되지 않고, USB 를 꽂는 손에 차도 흔들림.
  // 켜자마자 기준점을 재서 가만히 있는데도 돌았음(실제 1 초에 약 10 도). 1 초 기다린 뒤 잼
  delay(1000);
  // 2 초 동안 가만히 두고 편향을 잰다. 이걸 빼면 차가 가만히 있어도 방향이 돈다.
  // 출발 카운트다운 때 한 번 더 잼 (countdownTick)
  long sum = 0;
  for (int i = 0; i < 200; i++) { sum += mpuRawZ(); delay(10); }
  gyroBias = sum / 200.0;
}

int16_t mpuRawZ() {
  Wire.beginTransmission(MPU);
  Wire.write(0x47);                          // GYRO_ZOUT_H
  Wire.endTransmission(false);
  Wire.requestFrom((uint8_t)MPU, (uint8_t)2, (uint8_t)true);
  // 시간 초과로 포기했으면 받은 값이 없음. 0 편향 근처 값을 돌려줘 방향이 튀지 않게 함
  if (Wire.getWireTimeoutFlag() || Wire.available() < 2) {
    Wire.clearWireTimeoutFlag();
    if (gyroBadSince == 0) gyroBadSince = millis() | 1;   // 0 은 '멀쩡함' 표시라 피함
    gyroFailCount++;
    mpuSetup();                              // 바로 다시 깨우고 범위를 다시 넣음
    return (int16_t)gyroBias;
  }
  gyroBadSince = 0;
  int16_t v = (Wire.read() << 8) | Wire.read();
  return v;
}

// ---------------------------------------------------------------- 센서
void sharpBegin() {
  pinMode(PIN_SHARP_FRONT, INPUT);           // 아날로그 입력. 따로 켤 것이 없다
}

// 샤프 센서 한 번 읽어 거리(mm). 범위 밖이거나 못 믿을 값이면 -1.
// 아날로그 값이 튀어서 여러 번 읽어 중앙값을 쓴다 (버블 정렬, 개수가 적어 충분하다).
int readSharp() {
  int s[SHARP_SAMPLES];
  for (uint8_t i = 0; i < SHARP_SAMPLES; i++) s[i] = analogRead(PIN_SHARP_FRONT);
  for (uint8_t i = 0; i < SHARP_SAMPLES - 1; i++)
    for (uint8_t j = 0; j < SHARP_SAMPLES - 1 - i; j++)
      if (s[j] > s[j + 1]) { int t = s[j]; s[j] = s[j + 1]; s[j + 1] = t; }
  int adc = s[SHARP_SAMPLES / 2];
  frontAdc = adc;
  if (adc <= SHARP_B) return -1;            // 전압이 바닥 — 아주 멀거나 아무것도 없음
  int mm = (int)(SHARP_K / (adc - SHARP_B));
  if (mm < SHARP_MIN_MM || mm > SHARP_MAX_MM) return -1;
  return mm;
}

// ---------------------------------------------------------------- 통신
uint8_t checksum(const char* s, uint8_t n) {
  uint8_t c = 0;
  for (uint8_t i = 0; i < n; i++) c ^= (uint8_t)s[i];
  return c;
}

void handleLine(char* line) {
  char* star = strchr(line, '*');
  if (!star) return;
  *star = 0;
  uint8_t want = (uint8_t)strtol(star + 1, NULL, 16);
  if (checksum(line, strlen(line)) != want) return;       // 깨진 줄은 버린다
  if (line[0] == 'B') {                                    // 부저: B,1 켜고 B,0 끈다
    int on;
    if (sscanf(line, "B,%d", &on) == 1) beepSet(on != 0);
    return;                                                // 부저는 lastCmdAt 을 건드리지 않는다
  }                                                        // (삑삑 소리가 watchdog 정지를 막으면 안 됨)
  if (line[0] == 'R') {
    // 시험용: R,1 이면 리모컨 기다림을 풀고 R,0 이면 다시 걺. motor_test.py, servo_test.py 만 씀.
    // 리모컨이 안 될 때도 바퀴 방향을 시험하려고 넣음. 감시 정지(0.3 초)는 그대로라 안전함
    int on;
    if (sscanf(line, "R,%d", &on) == 1) irPaused = (on == 0);
    return;
  }
  if (line[0] != 'C') return;
  int sp; int st;
  if (sscanf(line, "C,%d,%d", &sp, &st) != 2) return;
  cmdSpeedMMS = constrain(sp, -MAX_REV_MMS, MAX_SPEED_MMS);
  cmdSteerDeg = constrain(st / 10.0, -MAX_STEER_DEG, MAX_STEER_DEG);
  lastCmdAt = millis();
}

void readSerial() {
  while (Serial.available()) {
    char c = Serial.read();
    if (c == '\n' || c == '\r') {
      if (rxLen) { rxBuf[rxLen] = 0; handleLine(rxBuf); rxLen = 0; }
    } else if (rxLen < sizeof(rxBuf) - 1) {
      rxBuf[rxLen++] = c;
    } else {
      rxLen = 0;                                          // 너무 길면 버린다
    }
  }
}

void sendStatus(int appliedMMS, uint8_t flags) {
  char body[64];
  int n = snprintf(body, sizeof(body), "S,%lu,%d,%d,%d,%d,%d,%u",
                   // 나노의 int 는 ±32767 까지라 327 도/초를 넘으면 부호가 뒤집혀 보내짐. 끝에서 자름
                   millis(), (int)constrain(gyroDps * 100.0, -32000.0, 32000.0), measuredDeg * 10,
                   frontMM, rearMM, appliedMMS, flags);
  Serial.print(body);
  Serial.print('*');
  char hex[4]; snprintf(hex, sizeof(hex), "%02X", checksum(body, n));
  Serial.println(hex);
}

// ---------------------------------------------------------------- 부저
// 능동형 부저를 가정해 핀만 켜고 끈다. 수동형이면 이 두 함수만 tone/noTone 으로 바꾼다.
void beepSet(bool on) {
  if (USE_BUZZER) digitalWrite(PIN_BUZZER, on ? HIGH : LOW);
}

// ---------------------------------------------------------------- 출력
// 돌려주는 값은 모터에 실제로 준 속도(mm/s). 너무 느려서 모터를 껐으면 0 을 돌려줌
int applyOutputs(int speedMMS, float steerDeg) {
  steerServo.write(constrain(STEER_CENTER_DEG + STEER_DIR * STEER_GAIN * steerDeg, 0, 180));

  // 속도(mm/s)를 PWM(0~255)으로. 부호가 방향. 0 이 아니면 움직이기 시작하는 힘에서부터 비례
  int pwm = 0;
  int applied = speedMMS;
  if (speedMMS != 0) {
    pwm = MOTOR_START_PWM + (int)((long)abs(speedMMS) * (255 - MOTOR_START_PWM) / MAX_SPEED_MMS);
    // 너무 약하면 안 돌고 소리만 나므로, 움직이는 최소 힘으로 올리고 그 힘의 속도를 보고함.
    // 예전엔 꺼 버렸는데 건전지로 바꿔 눈금을 넓히니 오렌지파이의 최저 속도가 이 아래로 떨어져 차가 안 갔음
    if (pwm < MOTOR_MIN_PWM) {
      pwm = MOTOR_MIN_PWM;
      int slowest = (int)((long)(MOTOR_MIN_PWM - MOTOR_START_PWM) * MAX_SPEED_MMS / (255 - MOTOR_START_PWM));
      applied = speedMMS > 0 ? slowest : -slowest;
    }
  }
  pwm = constrain(pwm, 0, 255);
  if (pwm == 0) {                          // 정지
    analogWrite(PIN_MOTOR_A1A, 0); analogWrite(5, 0);
    analogWrite(PIN_MOTOR_A1B, 0); analogWrite(4, 0);
  } else if (speedMMS * DRIVE_DIR > 0) {   // 전진 (DRIVE_DIR 가 -1 이면 핀 쪽으로는 후진 출력)
    analogWrite(PIN_MOTOR_A1A, pwm); analogWrite(5, pwm);
    analogWrite(PIN_MOTOR_A1B, 0); analogWrite(4, 0);
  } else {                                 // 후진
    analogWrite(PIN_MOTOR_A1A, 0); analogWrite(5, 0);
    analogWrite(PIN_MOTOR_A1B, pwm); analogWrite(4, pwm);
  }
  return pwm == 0 ? 0 : applied;
}

// ---------------------------------------------------------------- 시작
void setup() {
  Serial.begin(115200);
  Wire.begin();
  // 자이로와 1 초에 10 만 박자로 말함. 40 만은 선이 짧고 깨끗할 때 얘기라, 선이 길고 진동이 있는 이 차에선
  // 약한 흔들림에도 깨졌음. 한 번 읽는 데 0.1 ms 가 0.4 ms 가 될 뿐이라 주행엔 영향 없음
  Wire.setClock(100000);
  // 자이로가 3 ms 안에 대답 안 하면 포기하고 넘어감. 예전엔 무한히 기다려서, 선을 건드려 자이로가
  // 순간 끊기면 아두이노 전체가 얼었음 (2026-10-28 센서 멈추고 보고 0 줄). 끝의 true 는 I2C 를 초기화하라는 뜻
  Wire.setWireTimeout(3000, true);

  sweepServo.attach(PIN_SWEEP_SERVO);
  steerServo.attach(PIN_STEER_SERVO);
  pinMode(PIN_MOTOR_A1A, OUTPUT);
  pinMode(PIN_MOTOR_A1B, OUTPUT);
  applyOutputs(0, 0);                       // 모터 정지 상태로 시작
  sweepServo.write(SWEEP_CENTER_DEG);
  if (USE_RC) pinMode(PIN_RC, INPUT);
  if (USE_BUZZER) { pinMode(PIN_BUZZER, OUTPUT); beepSet(false); }

  sharpBegin();
  mpuBegin();                                // 이 동안 차를 가만히 둘 것
  if (USE_IR) IrReceiver.begin(PIN_IR, DISABLE_LED_FEEDBACK);   // LED 피드백은 D13(부저)이라 끈다
  // 준비 끝 신호: 삐-삐 두 번. 켤 때 부트로더가 D13 을 깜빡여 나는 잡소리와 구별하려고 넣음.
  // 이 두 번이 들리면 자이로 영점까지 끝나 리모컨을 받을 수 있다는 뜻임
  for (uint8_t i = 0; i < 2; i++) { beepSet(true); delay(150); beepSet(false); delay(150); }
  lastCmdAt = millis();
  sweepMovedAt = millis();
}

// ---------------------------------------------------------------- 반복
void irBeep(int ms) { beepSet(true); delay(ms); beepSet(false); }

// 한 줄 끝에 *<검사값> 을 붙여 파이로 보냄
void sendLine(const char* b, int n) {
  Serial.print(b);
  Serial.print('*');
  char h[4];
  snprintf(h, sizeof(h), "%02X", checksum(b, n));
  Serial.println(h);
}

// 리모컨으로 정한 거리를 파이에 알린다: G,<cm>*<검사값>
void sendGoal(int cm) {
  char b[16];
  int n = snprintf(b, sizeof(b), "G,%d", cm);
  sendLine(b, n);
}

// 들은 리모컨 신호를 그대로 파이에 알림: I,<방식>,<주소>,<버튼>. 해석 못 한 것(방식 0)도 보냄.
// 리모컨이 안 먹을 때 수신기가 아예 못 듣는 건지(줄이 없음), 듣는데 못 알아듣는 건지(방식 0) 가리려고 넣음
void sendIr() {
  char b[24];
  int n = snprintf(b, sizeof(b), "I,%u,%u,%u", (unsigned)IrReceiver.decodedIRData.protocol,
                   IrReceiver.decodedIRData.address, IrReceiver.decodedIRData.command);
  sendLine(b, n);
}

// 부저를 ms 동안 울림. delay 로 기다리면 그동안 센서와 보고가 멈춰서, 끌 시각만 적어 두고 loop 에서 끔
void beepFor(unsigned long ms) {
  beepSet(true);
  beepOffAt = millis() + ms;
}

// 센서가 새로 잴 때마다 부름. 정면(0 도)에서 잰 것만 봄.
// ±15 도까지 보면 손바닥 가장자리가 15 도에서 멀게 잡혀 손을 치운 것으로 읽힐 수 있어서 정면만 씀
void handCheck(unsigned long now) {
  if (measuredDeg != 0) return;
  // 서 있을 땐 넓게(20 cm 안 어디든), 달릴 땐 좁게(10~15 cm). 서 있을 땐 기둥을 손으로 착각해도 위험하지 않음
  bool hand = irPaused ? (frontAdc >= HAND_ADC_MIN)
                       : (frontMM >= HAND_MIN_MM && frontMM <= HAND_MAX_MM);
  if (hand) handLastAt = now;
  if (!hand && handSince != 0 && now - handLastAt < HAND_GAP_MS) return;   // 잠깐 튄 값은 무시
  if (!hand) {
    handSince = 0;
    handMustLeave = false;
    if (handState == HAND_ARMED) {           // 손을 치웠음: 카운트다운 시작
      handState = HAND_COUNTDOWN;
      countdownAt = now;
      countdownBeeps = 0;
      biasSum = 0;
      biasCount = 0;
      biasFailStart = gyroFailCount;
    }
    return;
  }
  if (handMustLeave) return;
  if (handSince == 0) handSince = now;
  if (handState == HAND_COUNTDOWN) {          // 카운트다운 중에 손이 다시 오면 취소
    handState = HAND_WAIT;
    handMustLeave = true;
    beepFor(400);
    return;
  }
  if (!irPaused && now - handSince >= HAND_STOP_MS) {
    irPaused = true;
    handState = HAND_WAIT;
    handMustLeave = true;
    beepFor(400);
  } else if (irPaused && handState == HAND_WAIT && now - handSince >= HAND_START_MS) {
    handState = HAND_ARMED;
    beepFor(200);
  }
}

// 카운트다운: 1 초마다 짧게 울리고, 다 울면 출발
void countdownTick(unsigned long now) {
  if (handState != HAND_COUNTDOWN) return;
  if (countdownBeeps < COUNTDOWN_BEEPS) {
    if (now - countdownAt >= 1000UL * countdownBeeps) {
      beepFor(100);
      countdownBeeps++;
    }
  } else if (now - countdownAt >= 1000UL * COUNTDOWN_BEEPS) {
    // 3 초면 수백 번 모임. 자이로가 끊겨 거의 못 모았으면 켤 때 잡은 기준점을 그대로 씀
    if (USE_GYRO && biasCount > 50 && gyroFailCount == biasFailStart) gyroBias = (float)biasSum / biasCount;
    sendGoal(HAND_GOAL_CM);
    irHasGoal = true;
    irPaused = false;
    handState = HAND_WAIT;
  }
}

void loop() {
  readSerial();

  // ---- 자이로 (도/초)
  if (USE_GYRO) {
    int16_t gyroRaw = mpuRawZ();
    gyroDps = GYRO_DIR * (gyroRaw - gyroBias) / GYRO_LSB_PER_DPS;
    if (handState == HAND_COUNTDOWN) { biasSum += gyroRaw; biasCount++; }
  }

  // ---- 앞 센서: 서보가 멈춘 뒤에 잰다. 움직이면서 재면 엉뚱한 방향에 찍힌다
  unsigned long now = millis();
  mpuCheck(now);
  if (!sweepSettled && now - sweepMovedAt >= SWEEP_SETTLE_MS) sweepSettled = true;
  if (sweepSettled) {
    frontMM = readSharp();                   // 샤프는 늘 바로 값을 준다 (ToF 처럼 '준비중'이 없다)
    measuredDeg = sweepDeg;
    handCheck(now);
    if (irPaused) {
      // 기다리는 동안은 정면에 멈춰 둠. 좌우로 돌면 정면을 1 초에 한 번만 봐서 손을 잘 못 알아봤음.
      // 멈춰 있으면 0.1 초마다 정면을 봄. 출발하면 다시 훑고, 파이는 한 번 다 훑은 뒤에 출발함
      sweepDeg = 0;
      sweepServo.write(SWEEP_CENTER_DEG);
      sweepMovedAt = now; sweepSettled = false;
    } else {
      sweepDeg += sweepDir;                  // 다음 방향으로
      if (sweepDeg > SWEEP_MAX_DEG) { sweepDeg = SWEEP_MAX_DEG - SWEEP_STEP_DEG; sweepDir = -SWEEP_STEP_DEG; }
      if (sweepDeg < SWEEP_MIN_DEG) { sweepDeg = SWEEP_MIN_DEG + SWEEP_STEP_DEG; sweepDir =  SWEEP_STEP_DEG; }
      // 왼쪽이 양수 (link.py 와 같음)
      float gain = sweepDeg > 0 ? SWEEP_GAIN_LEFT : SWEEP_GAIN_RIGHT;
      sweepServo.write(constrain(SWEEP_CENTER_DEG + SWEEP_SERVO_DIR * gain * sweepDeg, 0, 180));
      sweepMovedAt = now; sweepSettled = false;
    }
  }
  // 뒤 거리 센서는 없다. rearMM 은 -1 로 남아 '못 맞힘'으로 보고된다.

  // ---- 안전 판단: 명령이 끊겼거나 사람이 가져갔으면 멈춘다
  uint8_t flags = 0;
  if (frontMM >= 0) flags |= 1;
  if (rearMM  >= 0) flags |= 2;
  bool manual = false;
  if (USE_RC) {
    unsigned long w = pulseIn(PIN_RC, HIGH, 25000);
    manual = (w > 1700);                     // 조종기 스위치를 올리면 사람이 운전
    if (manual) flags |= 4;
  }
  countdownTick(now);
  if (beepOffAt && now >= beepOffAt) { beepSet(false); beepOffAt = 0; }
  if (USE_IR && IrReceiver.decode()) {
    uint8_t c = IrReceiver.decodedIRData.command;
    if (!(IrReceiver.decodedIRData.flags & IRDATA_FLAGS_IS_REPEAT)) sendIr();
    // NEC 만 받게 했더니 리모컨이 아예 안 먹어서 '해석 못 함'만 버리는 예전 규칙으로 되돌림.
    // I 줄로 우리 리모컨의 진짜 방식과 주소를 알아낸 뒤 그것만 받게 좁힐 것
    if (IrReceiver.decodedIRData.protocol != UNKNOWN && !(IrReceiver.decodedIRData.flags & IRDATA_FLAGS_IS_REPEAT)) {
      int d = -1;
      for (int i = 0; i < 10; i++) if (IR_DIGITS[i] == c) d = i;
      if (!irPaused) { irPaused = true; irBeep(400); }                         // 달리는 중: 아무 버튼이나 정지
      else if (d >= 0) { irNum = (irNum * 10 + d) % 1000; irBeep(30); }       // 숫자
      else if (c == 0x09) { irNum = 0; irBeep(200); }                          // EQ: 지우기
      else if (c == 0x43 && (irNum > 0 || irHasGoal)) {                        // ▶||: 출발
        if (irNum > 0) { sendGoal(irNum); irNum = 0; irHasGoal = true; }
        irPaused = false; irBeep(100);
      }
    }
    IrReceiver.resume();
  }
  if (irPaused) { manual = true; flags |= 4; }
  bool late = (millis() - lastCmdAt) > WATCHDOG_MS;
  if (late) flags |= 8;
  // 0.2 초 넘게 계속 끊겨 있을 때만 알림. 그보다 짧으면 놓친 회전이 1~2 도뿐이라 그냥 달림
  if (gyroBadSince && now - gyroBadSince > GYRO_BAD_MS) flags |= 16;

  // 예전엔 모터를 꺼 놓고도 명령 속도를 그대로 보고해서, 파이가 서 있는 차를 가고 있다고 믿었음
  float appliedSteer = (late || manual) ? 0.0 : cmdSteerDeg;
  int applied = applyOutputs((late || manual) ? 0 : cmdSpeedMMS, appliedSteer);
  // 자이로가 없으면 준 속도와 조향각으로 도는 빠르기를 계산해 자이로 자리에 넣음 (자전거 모형).
  // 오렌지파이는 이걸 자이로 값으로 믿고 방향을 셈. 그래서 오렌지파이 코드를 안 바꿔도 방향이 맞음
  // 바퀴는 명령보다 STEER_GAIN 배 꺾이므로 그 각도로 셈
  if (!USE_GYRO) gyroDps = degrees(applied / 1000.0 * tan(radians(STEER_GAIN * appliedSteer)) / WHEELBASE_M);

  // ---- 상태 보고 (50 Hz)
  if (now - lastSendAt >= SEND_PERIOD_MS) {
    lastSendAt = now;
    sendStatus(applied, flags);
  }
}
