StarCoder14/Auto_DRIVING/(commit log)

2026-10-08 지금까지의 자율주행 알고리즘 프로젝트를 git 으로 처음 기록함
    접선 그래프에서 하이브리드 A* 로 바꾸기까지의 코드, 시험, 문서,
    실물 이식용 아두이노 펌웨어와 오렌지파이 주행 프로그램이 들어 있음.
    여기서부터 바뀌는 것은 기록으로 남김. 버릴것 폴더와 파이썬 캐시는 뺌
2026-10-08 계획서의 처음 기하 모델(알고리즘 A)을 코드로 옮김
    판별식, 수선의 발, 기울기 이차방정식 접선, 호의 길이를 교과서 방식 그대로 씀.
    눈앞의 가장 가까운 원 하나만 접선으로 비켜 가고, 수선의 발이 넘어가면 떠나고,
    처음 부딪힌 곳보다 가까울 때만 떠나는 기준선 규칙까지 계획서대로 넣음.
    계획서에 정해지지 않은 경우가 하나 있었음. 떠나는 순간 원 위에 서 있는데 그 원이
    다시 길을 막으면 접선을 그을 수 없음. 이때는 떠나지 않고 계속 따라 돌게 정함.
    무작위 1000개에서 981개 도착. 부풀린 원이 안 겹치는 415개는 전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
2026-10-19 차를 잰 값을 car_specs.py 한 곳에 적게 함
    실제 차는 앞뒤가 고르게 튀어나오지 않을 수 있는데, 뒷바퀴 축에서 차 끝까지의
    계산식이 파일 다섯 곳에 복사돼 있었음. VehicleParams 로 모으고 잰 값을 넣을 자리를 만듦.
    car_specs.py 에 cm 로 적으면 실물 주행, run.py --car ours, 처음 기하 모델이 따라감.
    최대 조향각은 바깥 앞바퀴가 그린 원 지름으로 거꾸로 구함. 각도기보다 정확함.
    아무것도 안 재면 예전과 결과가 완전히 같은 것을 확인함 (시뮬레이션 3판 비교, 시험 추가).
    센서가 앞 ToF 하나뿐인 것도 반영함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
2026-10-19 오차 분해 도구 첫 판 만듦 (run_error_split.py)
    같은 지도에서 한 번에 하나씩만 실제에 가깝게 바꿔 달림.
    0 다 아는 지도, 1 보이는 것만(이상적 센서), 2 실제 ToF 흉내, 3 엔코더 없는 위치 추정.
    실측 배치 파일과 실차 궤적 파일을 읽는 자리도 만듦.
    첫 측정에서 문제를 찾음. 무작위 지도 12개 중 8개에서 다 아는 차가 더 길게 달림.
    계획기가 길이가 아니라 여유 벌점이 든 비용을 줄이기 때문임. 지표를 정한 뒤 고칠 것
2026-10-19 오차 분해 지표를 길이, 차체 여유, 도달 오차를 함께 보게 바꿈
    길이 비만 보면 보이는 것만 아는 차가 더 짧아서 모르는 게 낫다는 틀린 결론이 나옴.
    계획기가 여유 벌점이 든 비용을 줄이기 때문임. 기태와 상의해서 A안으로 정함:
    실차와 같은 계획기를 그대로 쓰고, 차체 사각형 기준 최소 여유와 위치 추정 오차를 지표에 더함.
    지도 30개 예비 결과 (시뮬레이터 기본 차): 알고리즘 몫은 여유 -6.4 cm,
    센서 몫은 길이 +7.6%, 위치 추정 몫은 도달 오차 +30.5 cm. README 에 정리함
2026-10-19 뒤 센서 없이 달리게 하고 주행 기록을 남기게 함
    센서가 앞 ToF 하나뿐이라 후진 탈출을 끔. 출발 준비 뒤 5 초 동안 계속 서 있으면
    '갇힘' 으로 끝내고 섬. 처음엔 1 초에 25 번 멈춤을 갇힘으로 봤는데 출발 직후 첫 경로를
    찾는 동안까지 걸려서 바꿈. 처음 보는 지도 40 개에서 38 개 도착, 2 개는 안전하게 멈춤.
    펌웨어는 USE_REAR_TOF = 0 이면 없는 센서를 안 건드리고 후진 명령도 0 으로 자름 (컴파일 확인).
    run_robot.py 는 매번 logs/ 에 50 Hz 주행 기록 CSV 를 남기고,
    run_error_split.py 가 그 기록과 바닥 궤적으로 실차 위치 추정 오차를 냄.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
2026-10-19 보드로 보내는 명령 하나로 묶음 (deploy.py)
    파일마다 scp 를 치던 것을 하나로 묶음. rccar, tests, run*.py, layouts 를
    tar 로 묶어 보내고(recordings, logs, 버릴것, __pycache__ 는 뺌, 48개 160KB),
    보드에서 빠른 시험과 계획 주기 시간 측정까지 돌림. --pull-logs 로 주행 기록을 가져옴.
    핀은 펌웨어에만 필요해서 차체 확정 전에도 보드 속도를 미리 잴 수 있음.
    접속이 안 될 때 노트북과 보드의 대역이 갈린 것을 짚어주는 안내도 넣음.
    2026-10-19 현재 보드가 192.168.1.x, 노트북이 192.168.100.x 로 갈려 접속 안 됨. 실물_올리기.md 에 기록함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
2026-10-19 출발 전 삑삑 카운트다운 추가. 전원만 켜면 안 달리고, 명령을 쳐야 출발함
    키보드 없이도 알아서 출발을 알리도록, run_robot.py 가 출발 전 10초 동안 부저를 울림
    (마지막 3초는 빠르게). 그 사이 사람이 키보드·모니터 선을 뽑음. --countdown 으로 조절.
    펌웨어에 B,<on> 명령과 부저 핀(D13) 추가. 능동형 가정이라 핀만 켜고 끔. 수동형이면
    beepSet() 한 곳만 tone 으로 바꾸면 됨. 부저 명령은 watchdog 을 안 건드려서
    카운트다운 중에도 모터는 정지 상태. 컴파일 확인(저장 50%). 가짜 아두이노와 시험 추가.
    조종기 스위치로 시작하는 기능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
2026-10-20 새 코드를 보드에 올리고 보드에서 돌아가는 것 확인함 (2026-10-21)
    172.16 망에서 접속됨. car_specs, error_split, 주행 기록, 삑삑 카운트다운,
    뒤 센서 없이 달리기까지 48개 파일을 보드로 보내고 시험 통과.
    가짜 아두이노 주행과 주행 기록 CSV 정상, 계획 평균 8.3 ms(예산 100 ms), 온도 48도.
    네트워크가 됐다 안 됐다 한 건 학교 변경이 아니라 노트북이 그날 붙는 Wi-Fi 차이였음.
    Windows scp 가 tar 스트리밍 중 멈추는 일이 있어, tar 를 파일로 만들어 보내는 게 안정적임.
    실물_올리기.md 에 기록함
2026-10-21 실측한 차 치수 넣음 (2026-10-21)
    전장 22cm, 전폭 12cm, 축거 15cm, 뒤 오버행 4cm(앞끝 18cm), 바퀴 지름 5.5cm.
    시뮬레이터 기본 차(48cm)의 절반 이하라, 계획 조각 길이 등 시뮬 설정을 차 크기에 맞게
    줄여야 함(다음 작업). 윤거, 최소 회전 반경, 센서 위치는 아직.
2026-10-21 앞 거리 센서를 샤프 적외선(GP2Y0A21)으로 바꾸고 교정함
    이 차는 계획서대로 레이저 ToF 대신 샤프 적외선 거리 센서를 씀. A0 아날로그로 읽고,
    1/거리가 ADC에 선형인 성질로 거리(mm)=K/(adc-B) 변환. 서보에 올려 좌우로 훑는 구조.
    실측 교정(firmware/sharp_calib 로 정면 고정하고 잼):
    20cm->276, 30cm->187, 40cm->146, 50cm->113, 60cm->93 (ADC).
    최소제곱으로 K=54428, B=5.16. 20~50cm 오차 몇 mm, 60cm 2cm.
    실물 확인: 자이로 영점/회전 정상, 샤프 거리 정상, 센서 서보 훑기 정상,
    조향/센서 서보 핀 바뀐 것 바로잡음(선 교체), 부저 D13 능동형 확인.
    firmware/sharp_ca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
2026-10-21 다음 할 일 정리 (2026-10-21)
    센서 끝. 남은 하드웨어: 조향 서보(D10), 구동 모터(D11) 테스트, 서보/모터 전원 분리.
    측정 남은 것: 윤거 다시, 최소 회전 반경. 소프트: 시뮬 설정을 차 크기에 맞게 축소.
    이어서 할 때 이 파일 먼저 보면 됨
2026-10-21 Switch motor output to L9110S driver
2026-10-26 모터 2개(L9110S A/B 채널, D4~D7) 펌웨어로 바꿈
    Claude-Session: https://claude.ai/code/session_01UAEbaw87kCgZ8JfSBD47Ax
2026-10-26 적외선 리모컨으로 출발/정지 (아무 버튼 한 번씩 누를 때마다 바뀜, 켜면 멈춘 상태)
    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
2026-10-26 리모컨 숫자로 갈 거리(cm) 정하기: 숫자 + ▶|| 출발, 달리는 중 아무 버튼 정지, EQ 지우기
    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
2026-10-27 인수인계 정리: 보드에서 시험한 펌웨어로 맞춤, 배선표·업로드 방법·리모컨 기록, 자동 시작 스크립트
    - 펌웨어: 보드에 올라간 것과 같은 방식(A 채널 D6/D7, B 채널 D5/D4에 같은 값)
    - 실물_올리기.md: 2026-10-26 기준 배선표, 6-7절(오렌지파이 직결, arduino-cli, --clean, 리모컨)
    - 다음_할일.md: 인수인계 (확인된 것/안 된 것, 다음 순서, 주의)
    - scripts/start_car.sh: 켜지면 run_robot 을 띄워 리모컨 대기
    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
2026-10-27 바퀴 띄우고 쓰는 시험 파일 되살림 (모터, 조향 서보, 리모컨 코드 확인)
    브랜치 내용을 main 에 합친 뒤, 치워 뒀던 작업 중 쓸 만한 것만 꺼냄.
    치워 둔 펌웨어는 D3/D11 배선 기준이라 지금 차(D4~D7)와 안 맞아 안 가져옴.
2026-10-27 앞 센서를 샤프(10~80cm)로 알게 하고, 모터가 꺼지는 느린 속도 문제 고침
    파이썬이 아직 3m 레이저로 알고 있어서 '못 맞힘'이 오면 3m 앞까지 비었다고 칠했음.
    그러면 1m 앞에서 본 기둥이 지워짐. 이제 80cm 까지만 비었다고 칠함.
    펌웨어는 힘 60 아래면 모터를 끄는데도 명령 속도를 그대로 보고했음.
    이제 끈 때는 0 을 보고하고, 파이썬도 그보다 느린 명령은 안 보냄 (최소 약 0.34 m/s).
    가짜 아두이노도 같은 규칙으로 흉내 냄. 펌웨어는 컴파일만 확인함, 보드에 아직 안 올림.
2026-10-27 길 찾기 설정을 22cm 차와 1.5m 시험장에 맞추고, 실제 차 지도 버그 세 개 고침
    큰 차(48cm) 설정 그대로면 가상 시험장 10 개 중 목적지 43cm 앞에서 서고, 2 번 기둥에 닿고, 2 번 갇혔음.
    car_specs.small_car_settings 에 작은 차 설정을 모으고 run_robot.py 가 이걸 씀.
    실제 차에서도 생기는 버그
    - 펌웨어가 잰 거리를 '다음에 돌아갈 방향'과 같이 보냈음. 이제 잰 방향을 보내고, 안 쟀으면 999도
    - 파이썬이 한 번 잰 값을 상태 줄마다 4~5 번 지도에 칠했음. 이제 새로 잰 것만 한 번
    - 막힘은 가운데 한 점, 비었음은 빛 폭 전체에 칠해서 가는 기둥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
2026-10-27 오렌지파이 자동 시작 고침: 한글 출력, 빨리 죽으면 쉬기, 부팅 예약 한 번에 넣는 파일 추가
    모니터 없이 부팅 예약으로 켜지면 파이썬이 한글을 못 찍고 죽어서 PYTHONIOENCODING=utf-8 을 넣음.
    주행 프로그램이 켜자마자 죽으면 3 초마다 포트를 다시 열어 나노가 계속 다시 켜지고 삑삑거림.
    그래서 10 초 안에 죽으면 30 초 쉬게 함. 기록에 시작, 끝 시각과 종료 코드를 남김.
    install_autostart.sh 는 부팅 예약(crontab)에 한 줄을 넣고 빼는 일만 함. 다른 예약은 안 건드림.
    셸 파일은 윈도우에서 받아도 줄 끝이 LF 로 남게 .gitattributes 를 넣음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
2026-10-27 deploy.py 가 차가 실제로 쓰는 ~/Auto_DRIVING 으로 보내고, 보낸 뒤 지문으로 확인하게 함
    예전엔 ~/rccar 로 보내서 차가 쓰는 폴더에는 안 들어갔음. scripts/, firmware/, 시험 파일도 같이 보냄.
    셸 파일은 줄 끝을 LF 로 바꿔 넣고 실행 권한을 줌. 보낸 뒤 차가 쓰는 파일 7 개의 md5 를
    노트북과 보드에서 비교해서 하나라도 다르면 실패로 알림.
    보드에서 도는 빠른 시험 목록에 1.5m 시험장 10 개 주행도 넣음.
2026-10-27 펌웨어에 준비 끝 삐-삐 신호와 NEC 리모컨만 받기 추가함. 켤 때 나는 잡소리와 구별되고, 잡음이 숫자로 읽히는 걸 막음
2026-10-27 아두이노가 얼지 않게 자이로 기다림에 3ms 한도를 두고, 리모컨 신호를 전부 알리게 하고, 센서를 75도까지만 돌게 함. 아두이노가 조용하거나 자이로가 이상하면 파이가 길을 안 찾고 출발도 안 함
2026-10-27 센서 서보 왼쪽만 0.8 배로 덜 돌게 보정함. 같은 75 도를 시켜도 왼쪽이 더 가서 보드에 닿았음
2026-10-27 센서 서보 방향을 뒤집음. 서보는 각도를 키우면 오른쪽으로 도는데 코드는 왼쪽을 양수로 써서 지도가 좌우로 뒤집혀 있었음
2026-10-27 보고서 원고 파일 만들고 서론 씀. 제목 확정, 20쪽 안에 맞추려고 장별 쪽수 배분도 적어 둠
2026-10-27 보고서 선행 연구 요약 다듬어 넣음. 비홀로노믹 설명 바로잡고 Bug 알고리즘을 추가함
2026-10-27 보고서에 선행 연구와 본 연구의 관계, 참고문헌 7개 추가함. 우리가 쓴 방법마다 원래 출처를 밝혀 둠
2026-10-28 보고서 본론의 연구 방법, 결과, 분석을 씀. 실차 실험 뒤 채울 곳은 빈칸으로 남김
2026-10-28 바퀴 방향 시험 준비함. 리모컨이 안 돼도 시험 파일이 모터를 풀 수 있게 R 명령을 넣고, 조향과 구동 방향을 숫자 하나로 뒤집을 수 있게 함
2026-10-28 모터 시험이 리모컨 잡음에 멈추지 않게 기다림 풀기를 매번 보내게 함. 모터가 돌자 잡음이 '정지' 로 읽혀 0.1 초 만에 멈췄음
2026-10-28 손으로 출발하고 세우는 기능 추가함. 리모컨은 잡음이 차를 멋대로 세워서 꺼 둠. 출발 신호를 받으면 기다리는 동안 칠한 지도를 지워 센서 앞에 댄 손이 기둥으로 남지 않게 함
2026-10-28 손을 기다리는 동안 센서를 정면에 멈춰 두고 20 cm 안이면 손으로 봄. 좌우로 돌 땐 정면을 1 초에 한 번만 봐서 손을 잘 못 알아봤음. 보고서에 센서 선이 D 핀에 꽂혔던 일 추가함
2026-10-28 자이로 눈금이 8 배 틀렸던 것과 부호가 반대였던 것 고침. 범위를 직접 정하고, 켤 때 1 초 기다려 기준점을 재고, 출발 카운트다운 동안 기준점을 다시 잡음
2026-10-28 오렌지파이가 켜지면 아두이노를 기다림으로 되돌리고 삐이 울림. 출발 신호 전엔 길을 안 찾고, USB 를 뽑아서 끝난 거면 30 초 쉬지 않음. 출발 신호를 놓쳐 99 m 자리표시로 헛돌던 일을 막음
2026-10-28 속도 계산을 바닥 실측(힘 100% = 1 초 10 cm)에 맞춤. 움직이기 시작하는 힘부터 비례하게 바꾸고 최소 힘을 올림. 오렌지파이가 96 cm 갔다고 믿을 때 실제로 3 cm 갔던 문제
2026-10-28 조향 방향을 뒤집음. 오른쪽 조향에 차가 왼쪽으로 돌아 나선을 그리며 감겨 들어갔음. 자이로 이상으로 서 있는 건 갇힘으로 세지 않음. 보고서 실물 문제 표에 조향 반대와 모터 전원 추가함
2026-10-28 자이로가 잠깐 끊겨도 버티게 함. 끊기면 바로 다시 깨워 범위를 다시 넣고, 0.2 초 넘게 계속될 때만 멈추며 회복되면 다시 감. 통신 속도를 100kHz 로 낮추고 0.5 초마다 설정을 확인함
2026-10-28 자이로 없이 달리게 함. 자이로 판을 꽂으면 I2C 선이 바닥에 붙어 아무 주소도 대답 안 하고 빼면 멀쩡해서 판 고장으로 봄. 펌웨어는 USE_GYRO 0 이면 자이로를 안 부르고, 오렌지파이는 조향각과 간 거리로 방향을 계산함. 가상 시험장 30 개 중 도착 26, 닿음 0 (자이로 있을 때 27, 0)
2026-10-28 아두이노가 자이로 대신 도는 빠르기를 계산해 보내게 함. 오렌지파이에 접속이 안 돼 새 코드를 못 옮겨서, 옛 코드가 믿는 자이로 자리에 속도 x tan(조향각) / 축거 를 넣음. 너무 약한 명령은 끄지 않고 최소 힘으로 올리고 그 속도를 보고함. 손 출발 목적지를 200 cm 로 늘림. 건전지 속도를 재는 임시 스케치 speed_test 추가함
2026-10-28 조향 서보를 명령의 1.5 배로 돌려 32 도 명령에 48 도까지 꺾이게 함. 오렌지파이는 32 도까지만 보내서 펌웨어에서 늘림. 계산한 자이로 값도 실제 꺾인 각도로 셈. 노트북 코드도 그 값을 믿게 USE_GYRO 를 True 로 바꿈. 목적지는 다시 100 cm 로 돌림
2026-10-30 보고서에 실제 주행 결과와 분석 추가함. 소화기 사이 통과, 좁은 틈 갇힘, 의자 다리 재현 안 됨, 조향 32 도와 48 도 차이, 소화기 인식 저하를 관찰 표와 원인 분석으로 정리함
2026-10-30 보고서 빈칸을 다 채우고 결론과 후속 연구를 씀. 실제 주행은 성공률 대신 실패 원인 분석으로 정리하고, 주행 기록 분석과 실제 차량 크기 오차 분해는 후속 연구로 넘김. 가상 시험장 도달 오차를 다시 재서 넣음
2026-10-30 보고서를 학교 양식 PDF 로 만드는 build_report.py 추가함. 양식 PDF 에서 뽑은 글씨 크기와 표지, 목차, 장 시작 띠를 그대로 씀. 목차에 맞춰 절 이름을 바꾸고 소화기 사이를 지나는 영상 사진을 그림 1 로 넣음
2026-10-30 보고서 표지에 팀원 학번과 이름을 넣음
2026-10-30 보고서에서 '지도 없는' 을 '사전 지도 없는' 으로 바로잡고 사전 지도와 주행 지도의 뜻을 서론에 정의함. 차는 지도를 만들어 가며 달리므로 지도가 아예 없는 게 아님. 제목도 바꾸고, 참고문헌 끝에 저장소 주소와 QR 코드를 넣음
2026-10-30 코드 보고서 docs/CODE_REPORT.md 씀. 구조, 기하 모델에서 하이브리드 A* 까지의 변천사, 실제 차로 옮기며 고친 코드를 git 기록의 고치기 전후로 보여줌. QR 로 들어오면 바로 보이게 GitHub 마크다운으로 씀
2026-10-30 README 첫머리를 지금 차에 맞게 고치고 코드 보고서로 가는 길을 넣음. QR 로 저장소에 들어오면 README 가 먼저 보이기 때문. 공개 저장소라 코드 보고서에서 팀원 학번과 이름은 뺌
2026-10-30 코드 보고서 1쪽 요약 docs/CODE_SUMMARY.md 씀. 구조 한 줄, 변천사 표, 판별식 코드, 실물에서 고친 것 5개만 남김. README 와 코드 보고서에서 바로 갈 수 있게 연결함
2026-10-30 README 와 코드 보고서 머리에 1쪽 요약으로 가는 링크 넣음
2026-10-30 보고서 그림을 소화기 사진에서 의자, 벽, 물병 실험 사진 두 개로 바꿈. 이 실험이 조향각에 따라 길이 달라진 걸 보여 줘서 가장 중요함. 19 쪽 그대로
2026-11-02 동아리 발표용 슬라이드 만듦. 알고리즘 변천사(판별식 -> 접선 그래프 A* -> 하이브리드 A*)를 직접 그린 개념 그림과 코드로 담음. slides.html 하나로 외부 의존성 없이 브라우저에서 방향키로 넘김
2026-11-02 자이로 주소 찾는 I2C 스캐너 스케치 추가함. 자이로 판이 응답을 안 할 때 어느 주소에 붙었는지 확인하려고 만듦
2026-11-02 최종 보고서 PDF와 생성 스크립트, 실험 사진, 발표 영상 추가함. build_report.py 로 학교 양식 PDF 를 뽑고, 의자 실험 사진 두 장과 시뮬레이터, 실제 주행 영상을 자료로 남김
2026-11-05 표지 이름을 git 이 무시하는 members.local.txt 에서 읽게 바꿈. 공개 저장소에 팀원 이름과 학번이 올라가면 안 되기 때문. 이름이 들어가는 report.html 과 보고서 PDF 도 올리지 않게 함
